Lintaroh/OMA68k/document/drawio/block_diagram.png

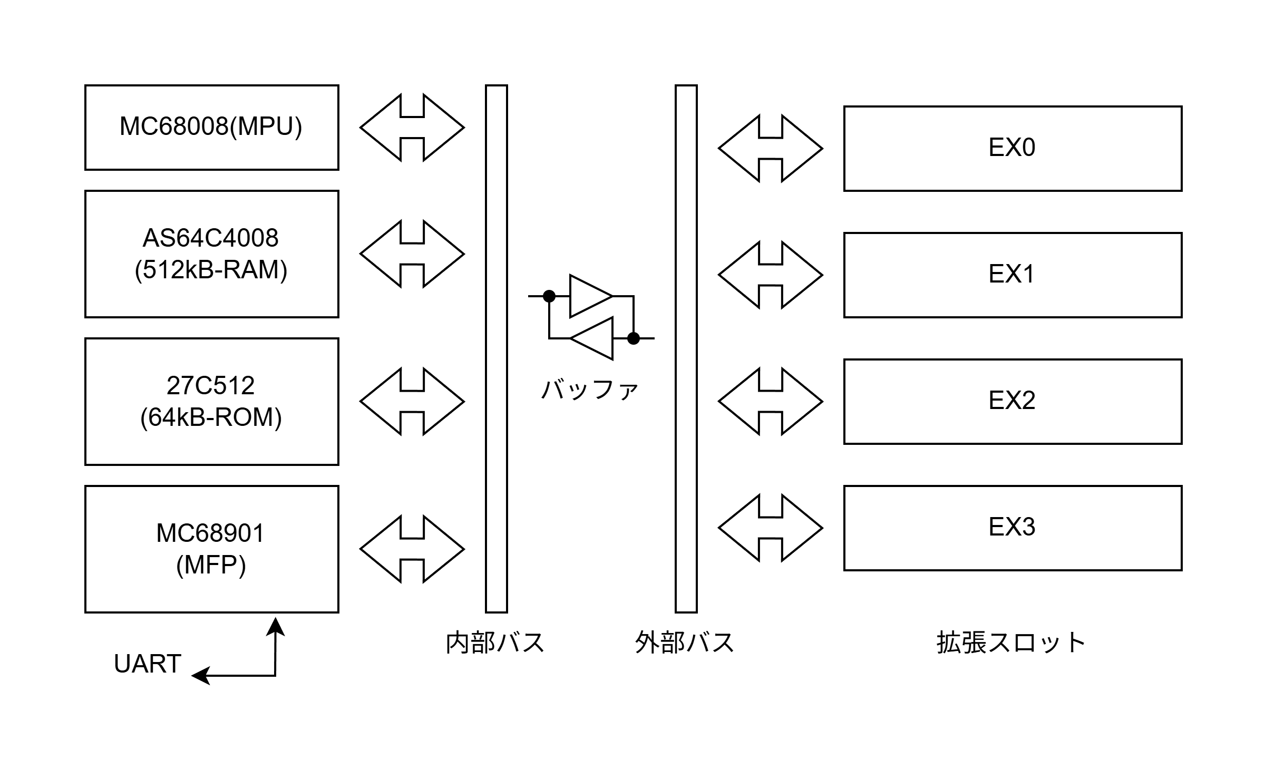
document/drawio/block_diagram.png
