Lintaroh/OMA68k/document/drawio/memorymap.png

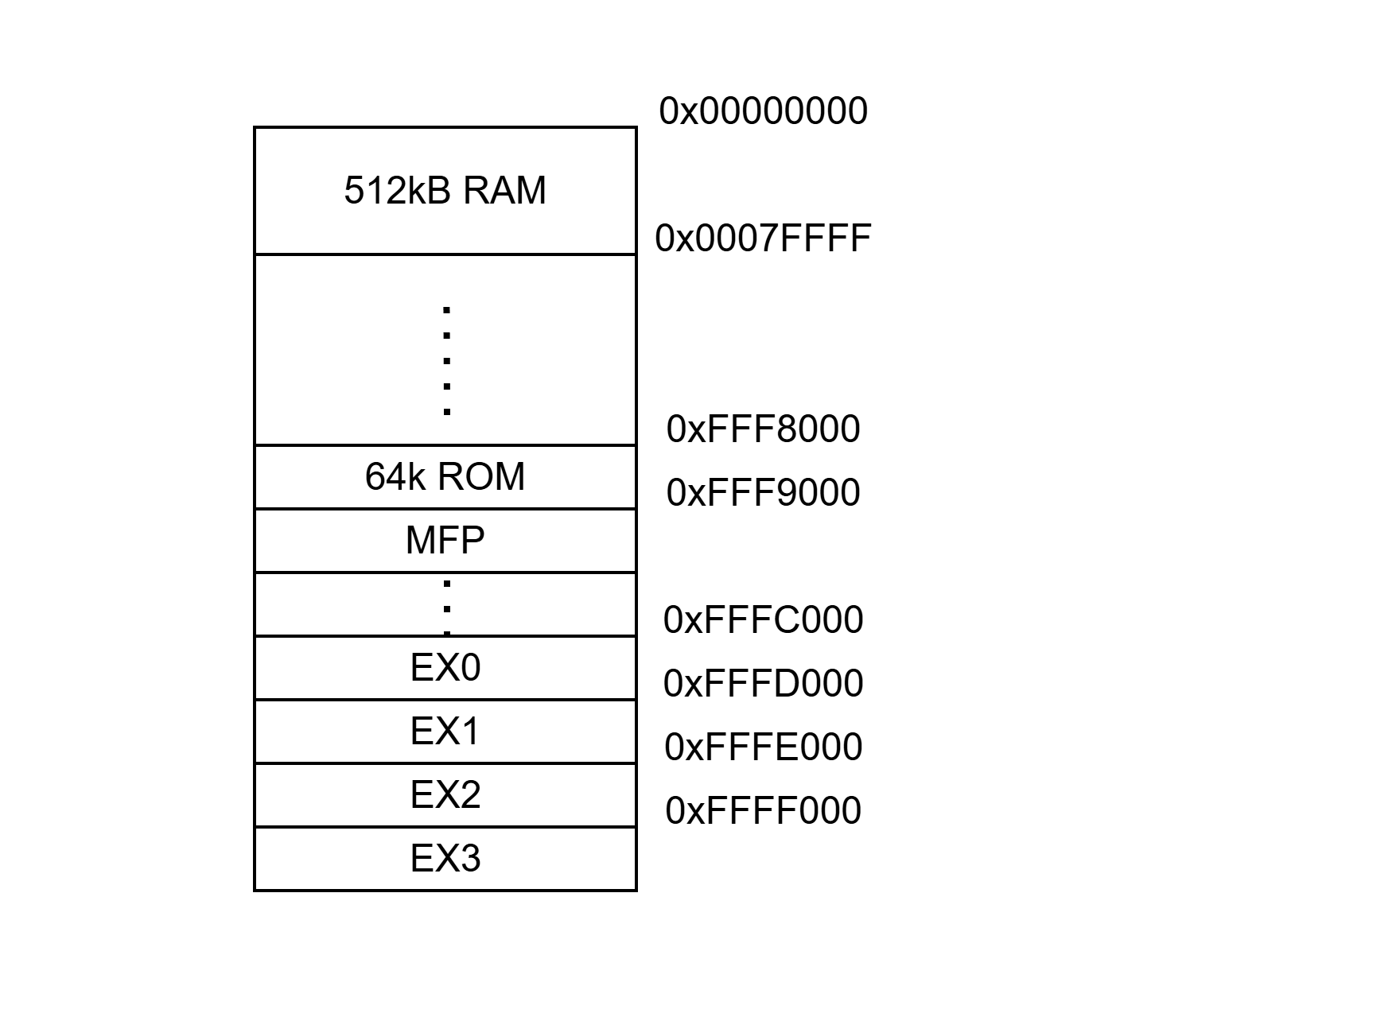
document/drawio/memorymap.png
