Lintaroh/OMA68k/(list of files, cad)

Other CAD files:
3D/48pin-socket.3dm
3D/64pin-socket.3dm
