Lintaroh/OMA68k/circuit/68k8-boad-fix/68k8-boad.pdf

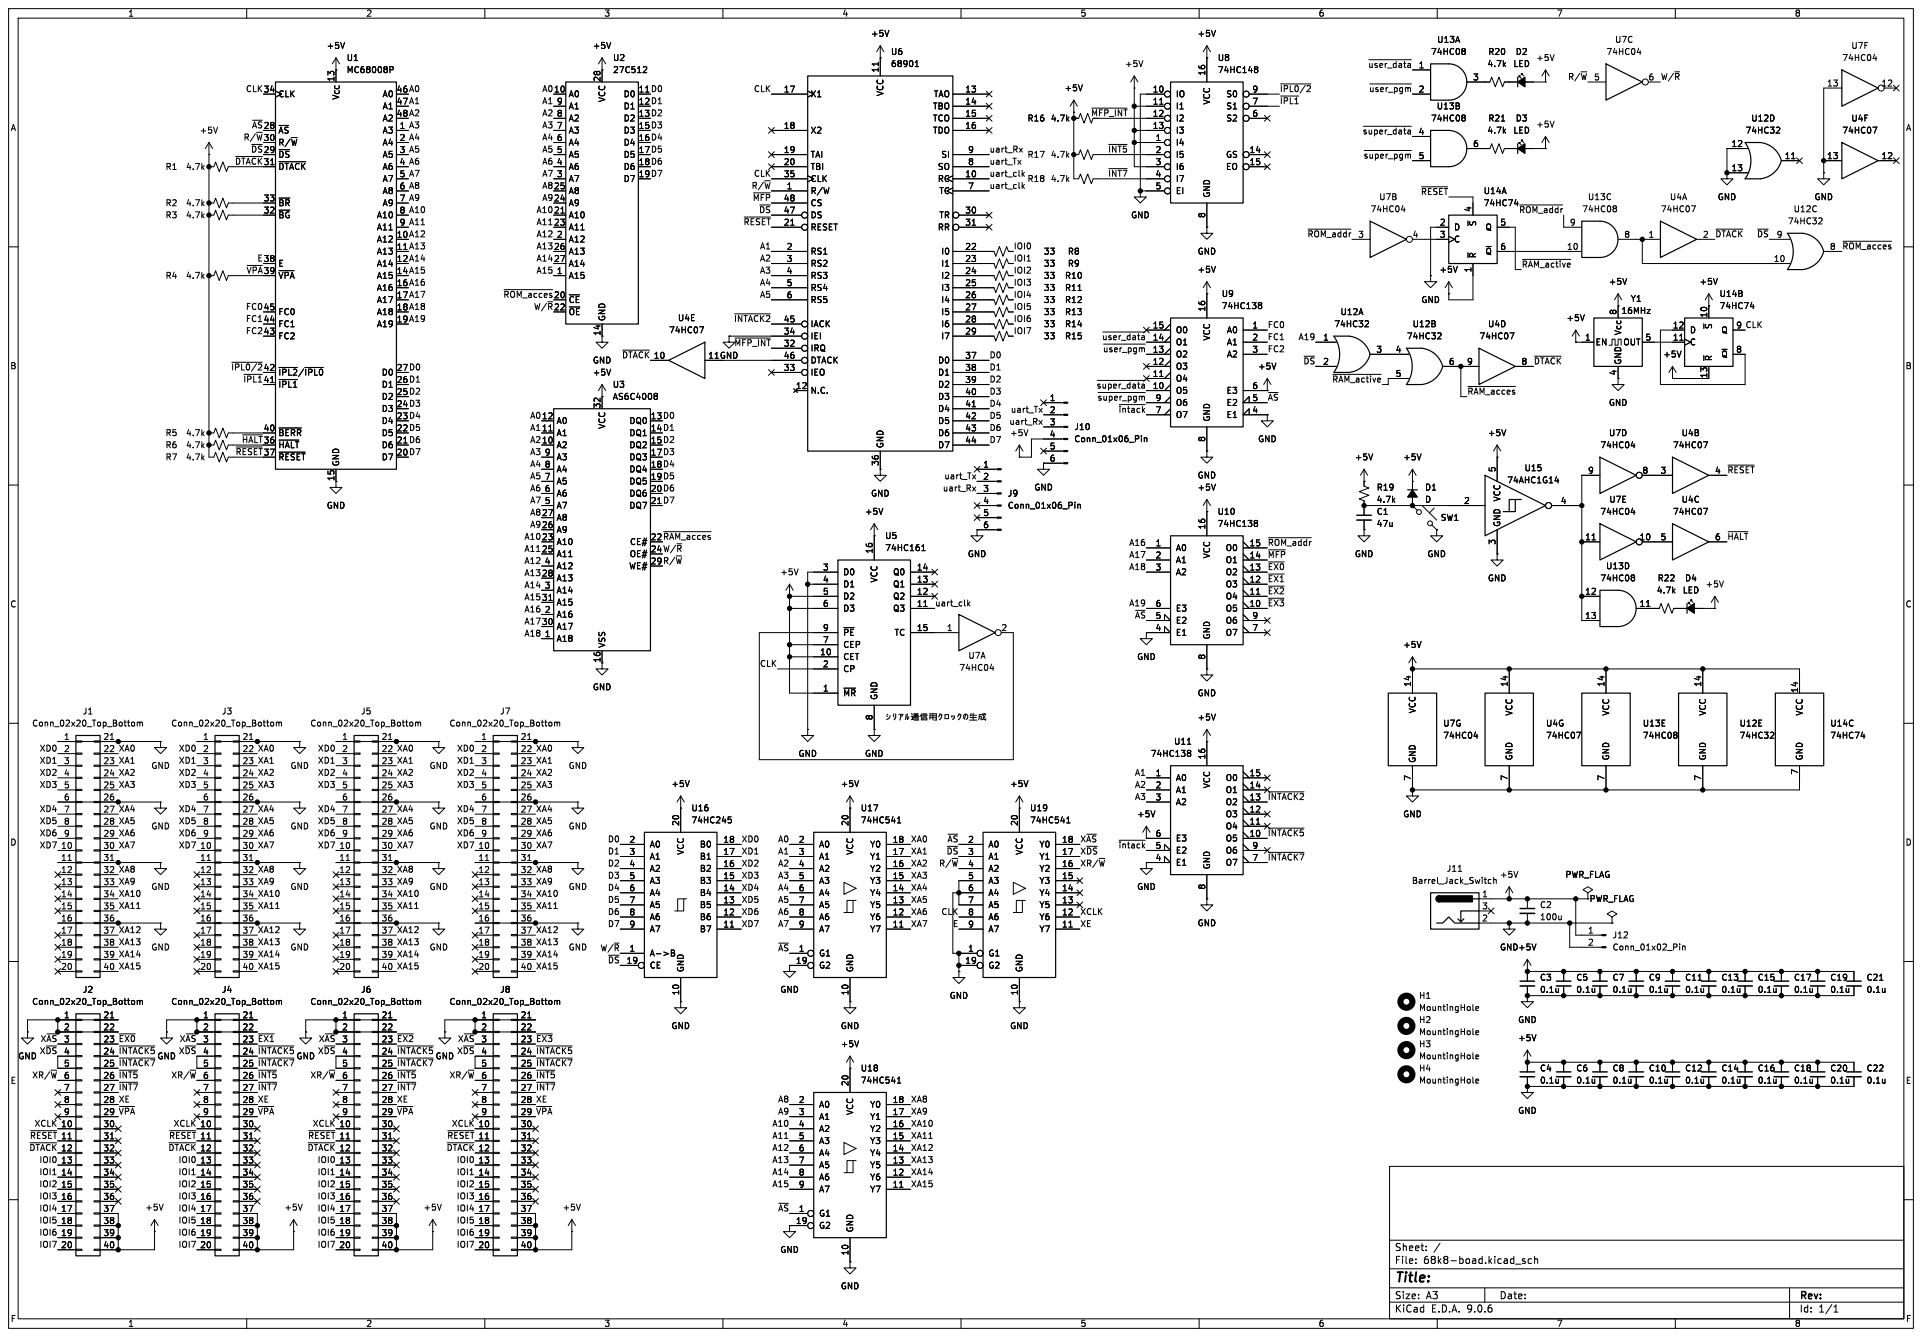
[picture p3: page 1]

CLK 34 ~{AS} 28 R/~{W} 30 ~{DS} 29 ~{DTACK} 31 ~{BR} 33 ~{BG} 32 E

U1 MC68008P CLK 34 ~{AS} 28 R/~{W} 30 ~{DS} 29 ~{DTACK} 31 ~{BR} 33 ~{BG} 32 E

H1 MountingHole H4 MountingHole H2 MountingHole H3 MountingHole

Id: 1/1 Title: File: 68k8-boad.kicad_sch Sheet: /
