Lintaroh/OMA68k/circuit/68k8-boad-fix/plots/68k8-boad__Assembly.pdf

# Reset RxD

# 74HC161 U7

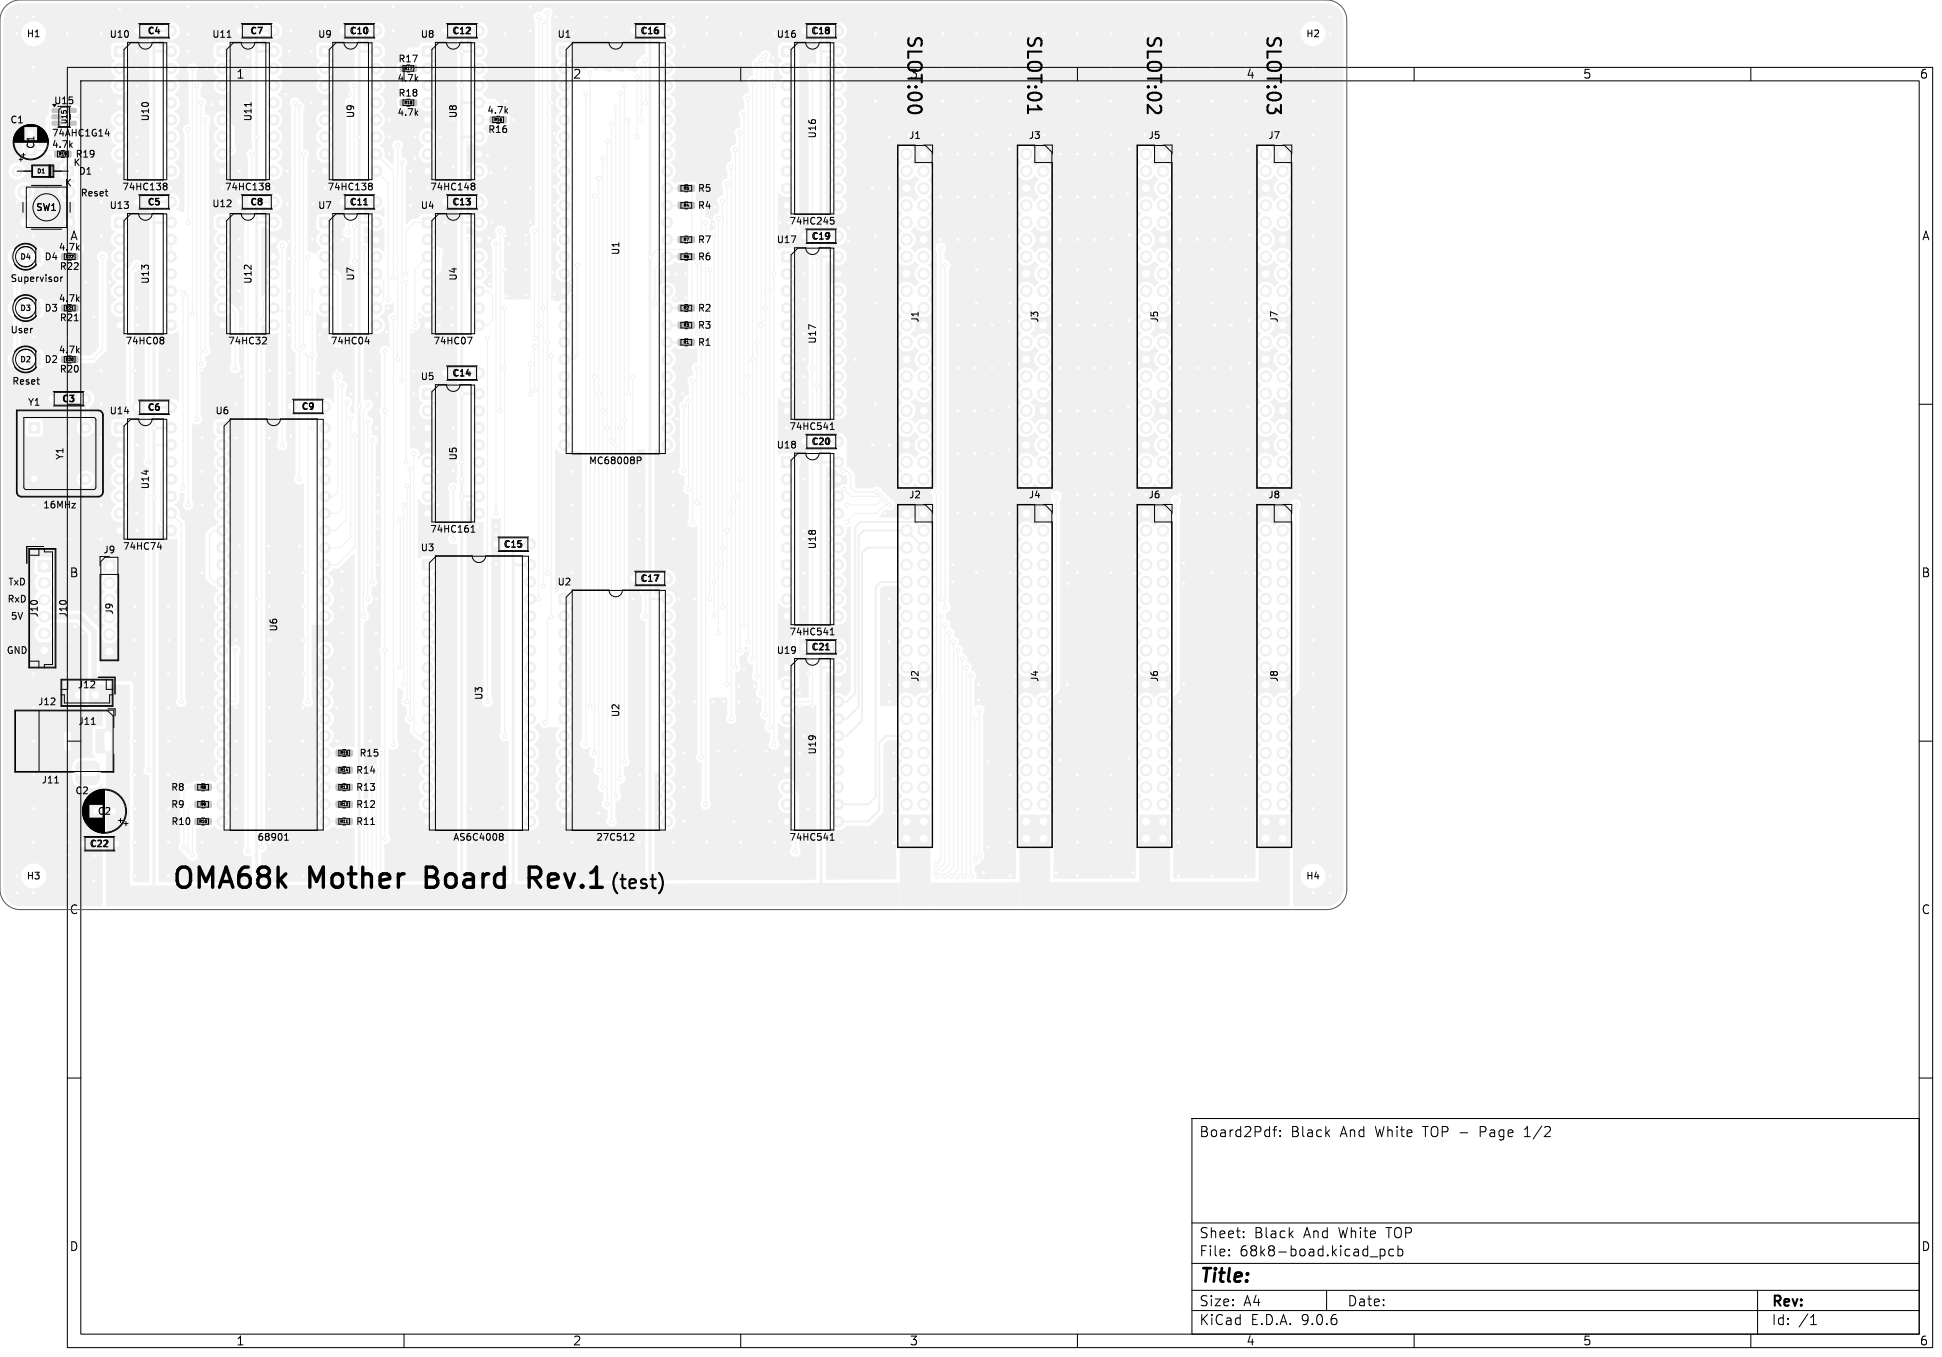
[picture p4: page 1]

Id: /1 Title: File: 68k8-boad.kicad_pcb Sheet: Black And White TOP

1 | 2 | 3 | 4 | 5 | 6

A

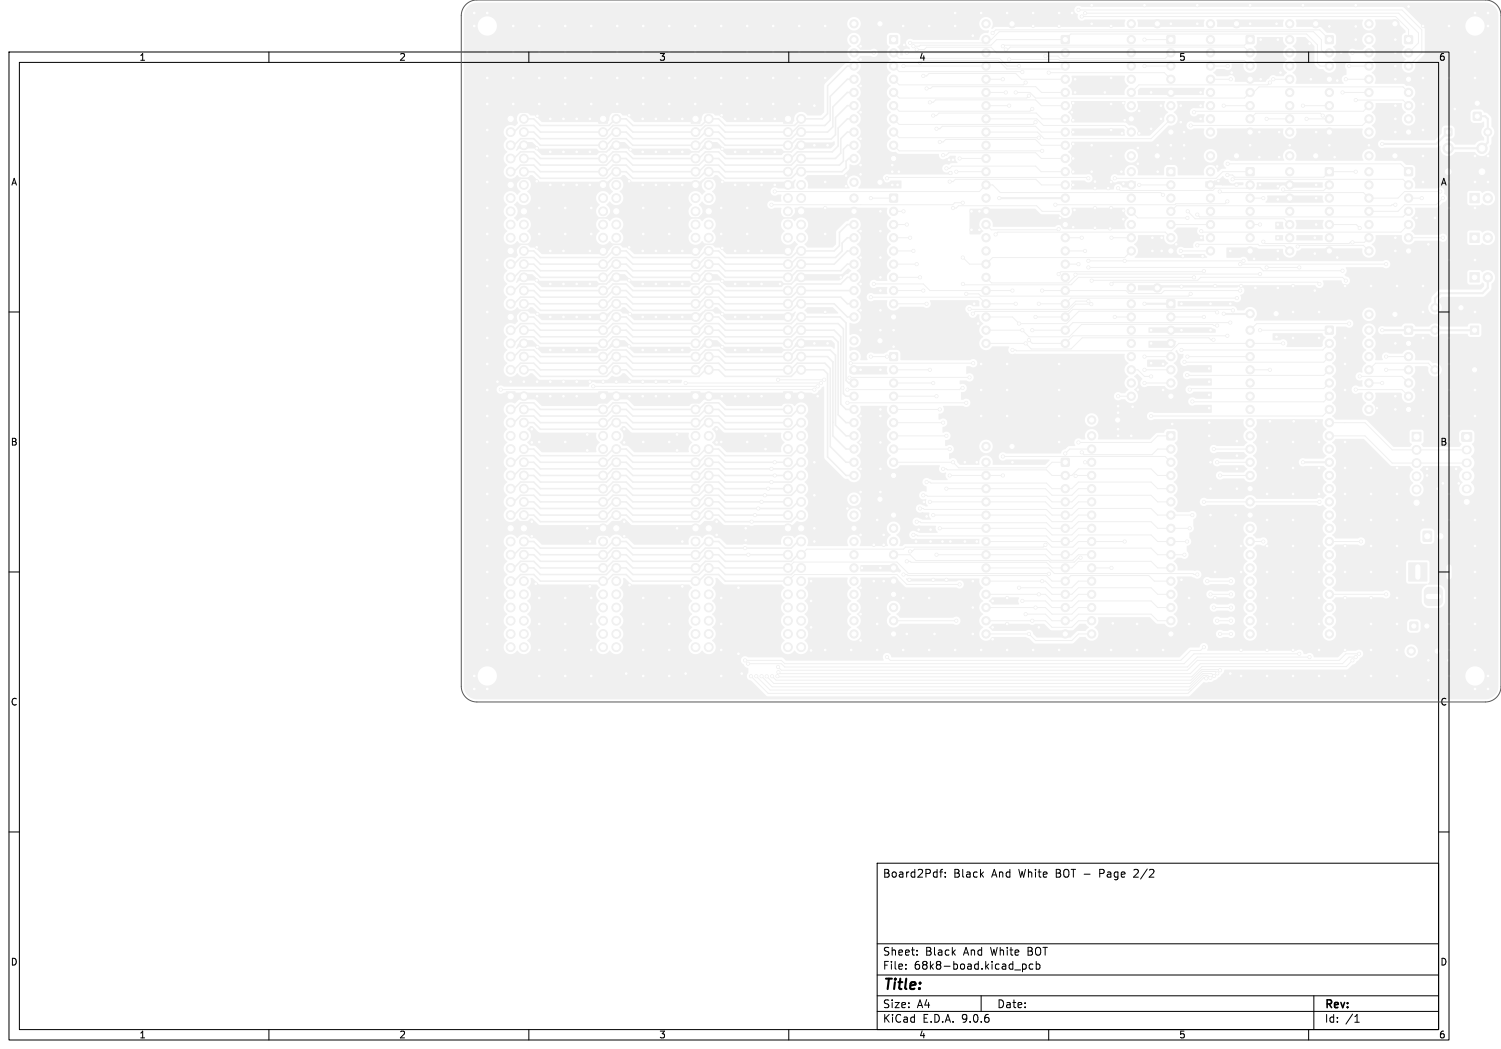
[picture p5: page 2]
D Date: KiCad; E.D.A. 9.0.6 Size: A4; Rev:; Id: /1 Title: File: 68k8-boad.kicad_pcb Sheet: Black And White BOT Board2Pdf:; Black And White BOT - Page 2/2
