Lintaroh/OMA68k/circuit/SD-board-pico/SD-board-pico.pdf

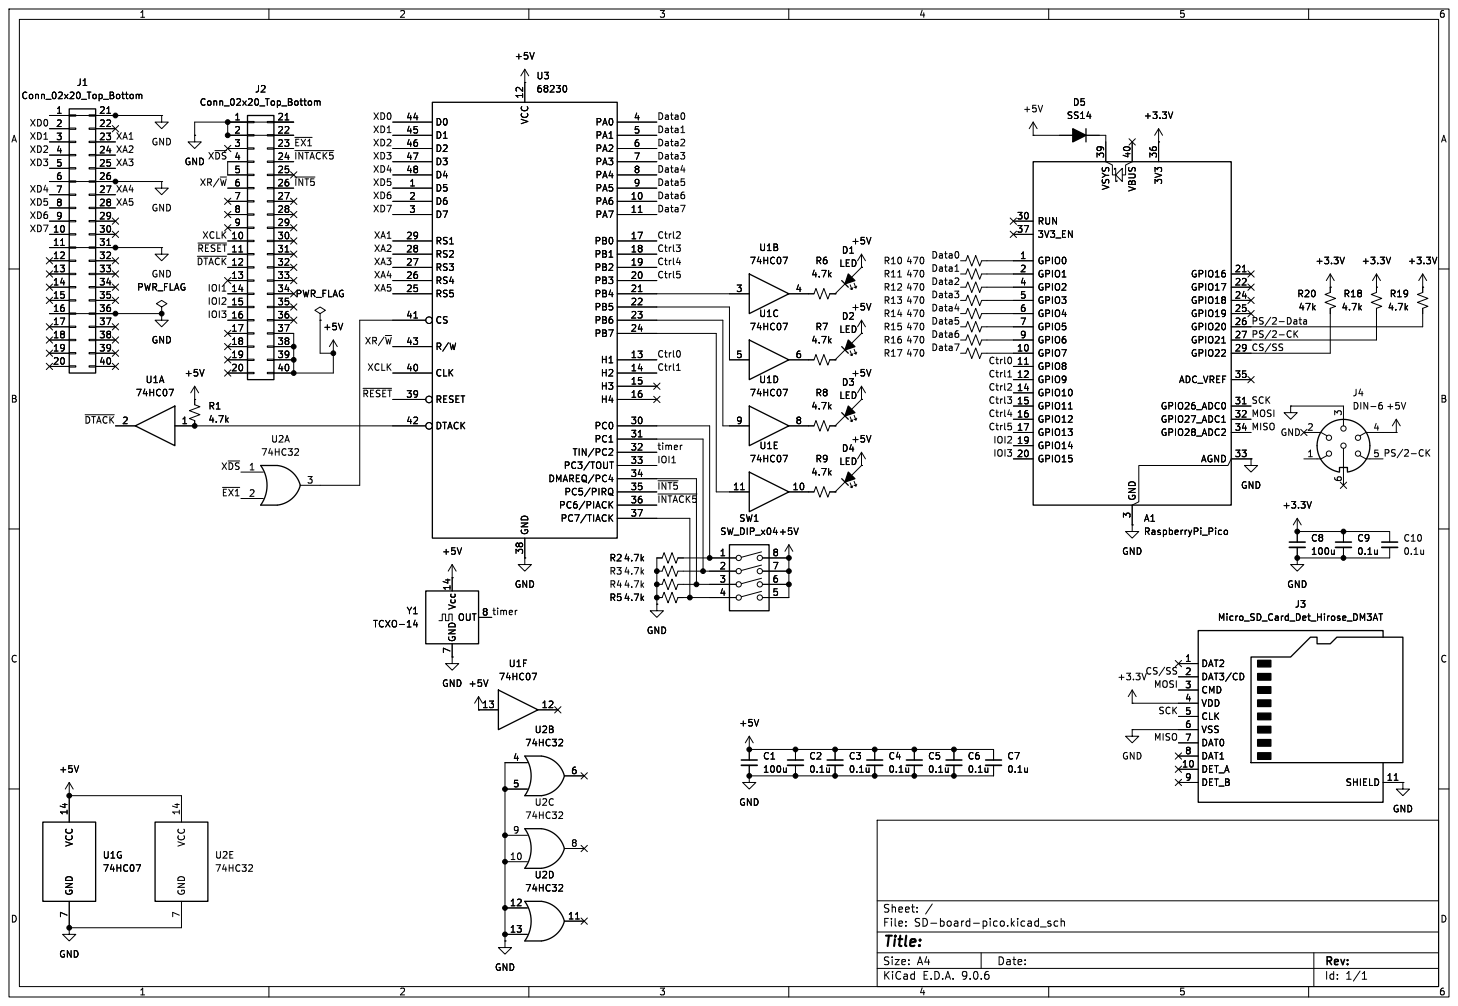
[picture p6: page 1]

Id: 1/1 Title: File: SD-board-pico.kicad_sch Sheet: / VCC 14 GND
