Lintaroh/OMA68k/circuit/SD-board/SD-board.pdf

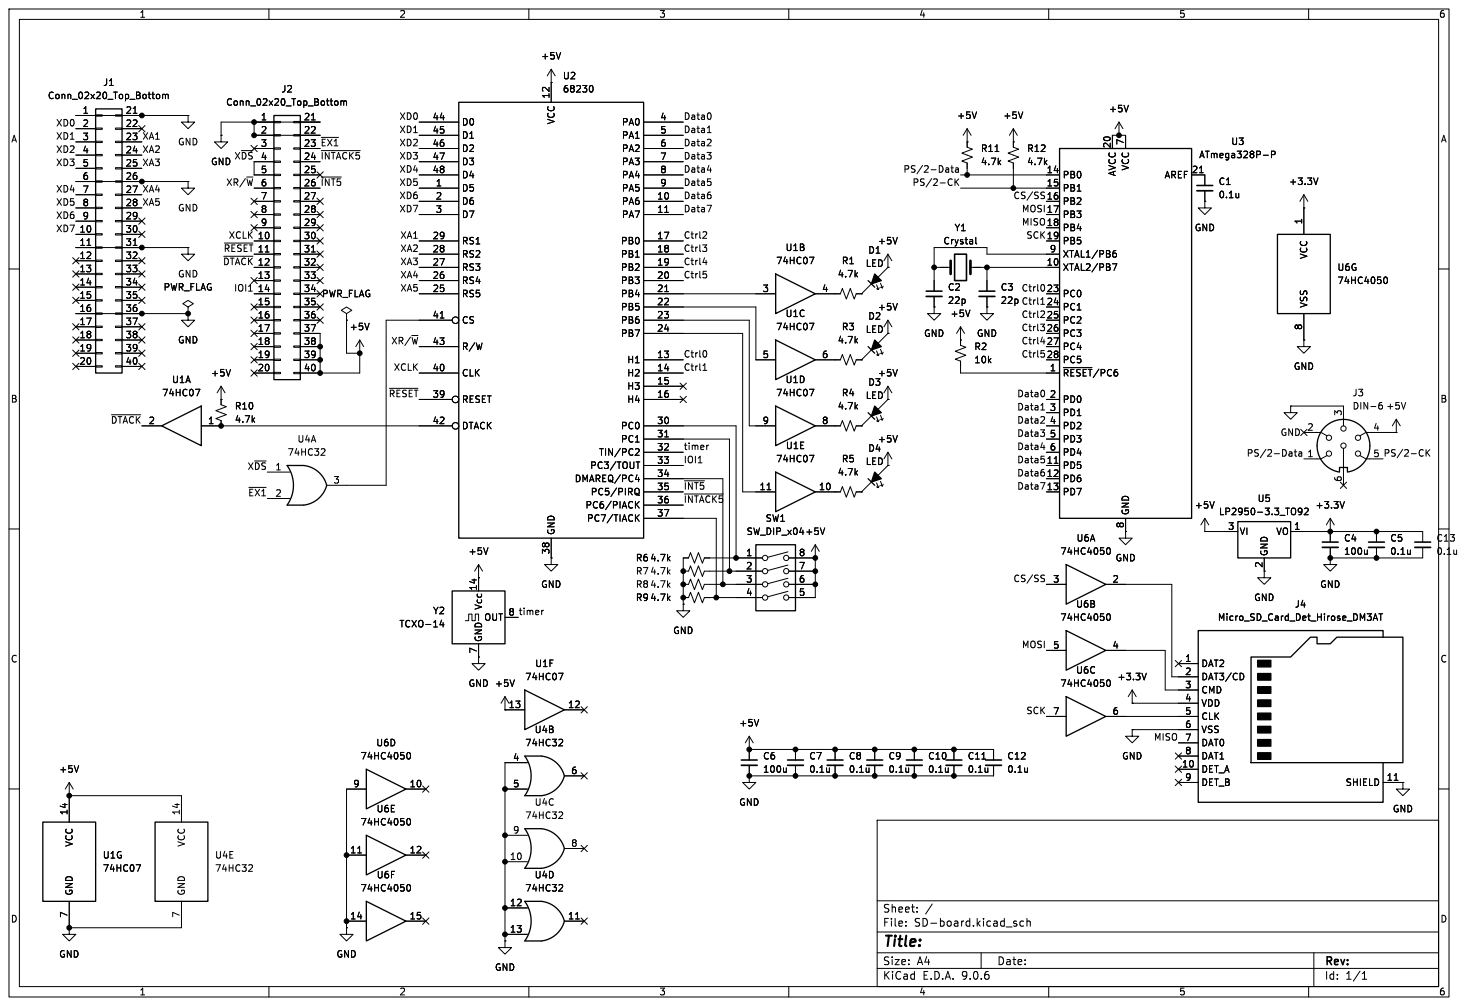
[picture p7: page 1]

Id: 1/1 Title: File: SD-board.kicad_sch Sheet: /
