Lintaroh/OMA68k/circuit/V9938-board/V9938-board.pdf

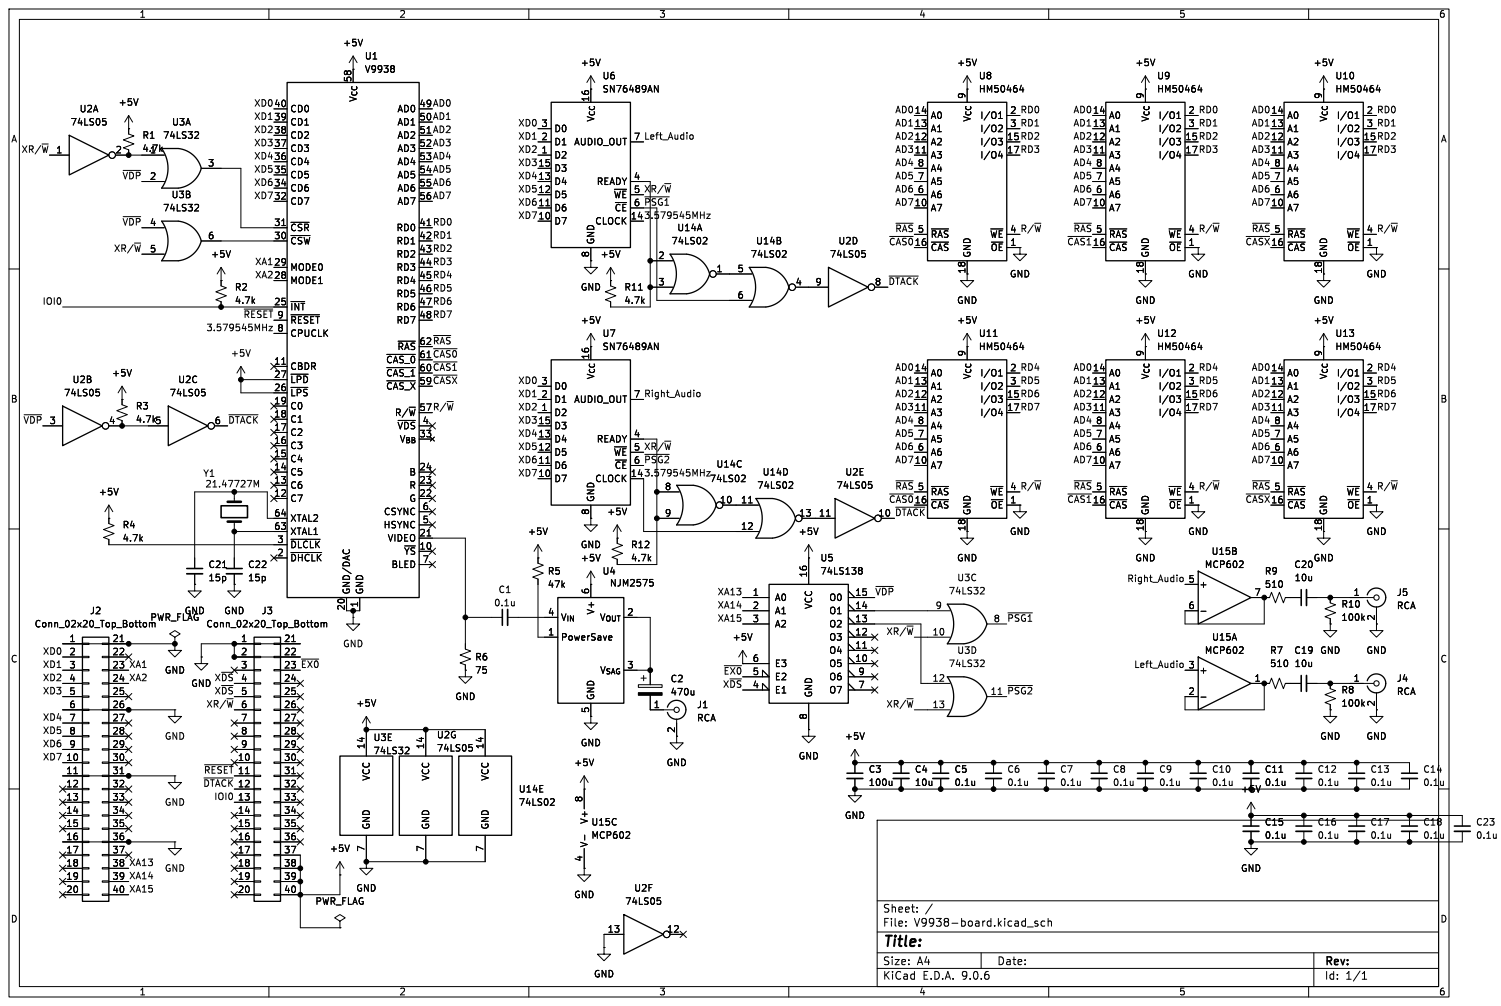
[picture p8: page 1]

22 CSYNC 6 HSYNC 5 VIDEO 21 ~{YS} 10 BLED 7 GND/DAC 20 +5V

8 AUDIO_OUT 7 READY 4 ~{WE}5 ~{CE}6 CLOCK 14 U6SN76489AN

8 AUDIO_OUT 7 READY 4 ~{WE}5 ~{CE}6 CLOCK 14 +5V R11

8 AUDIO_OUT 7 READY 4 ~{WE}5 ~{CE}6 CLOCK 14 U7SN76489AN

5 V_{OUT} 2 V_{SAG} 3 GND GND U2F
