Lintaroh/OMA68k/circuit/V9938-board/V9938-board.kicad_pcb

## KiCad design circuit/V9938-board/V9938-board.kicad_pcb (2026-05-15)

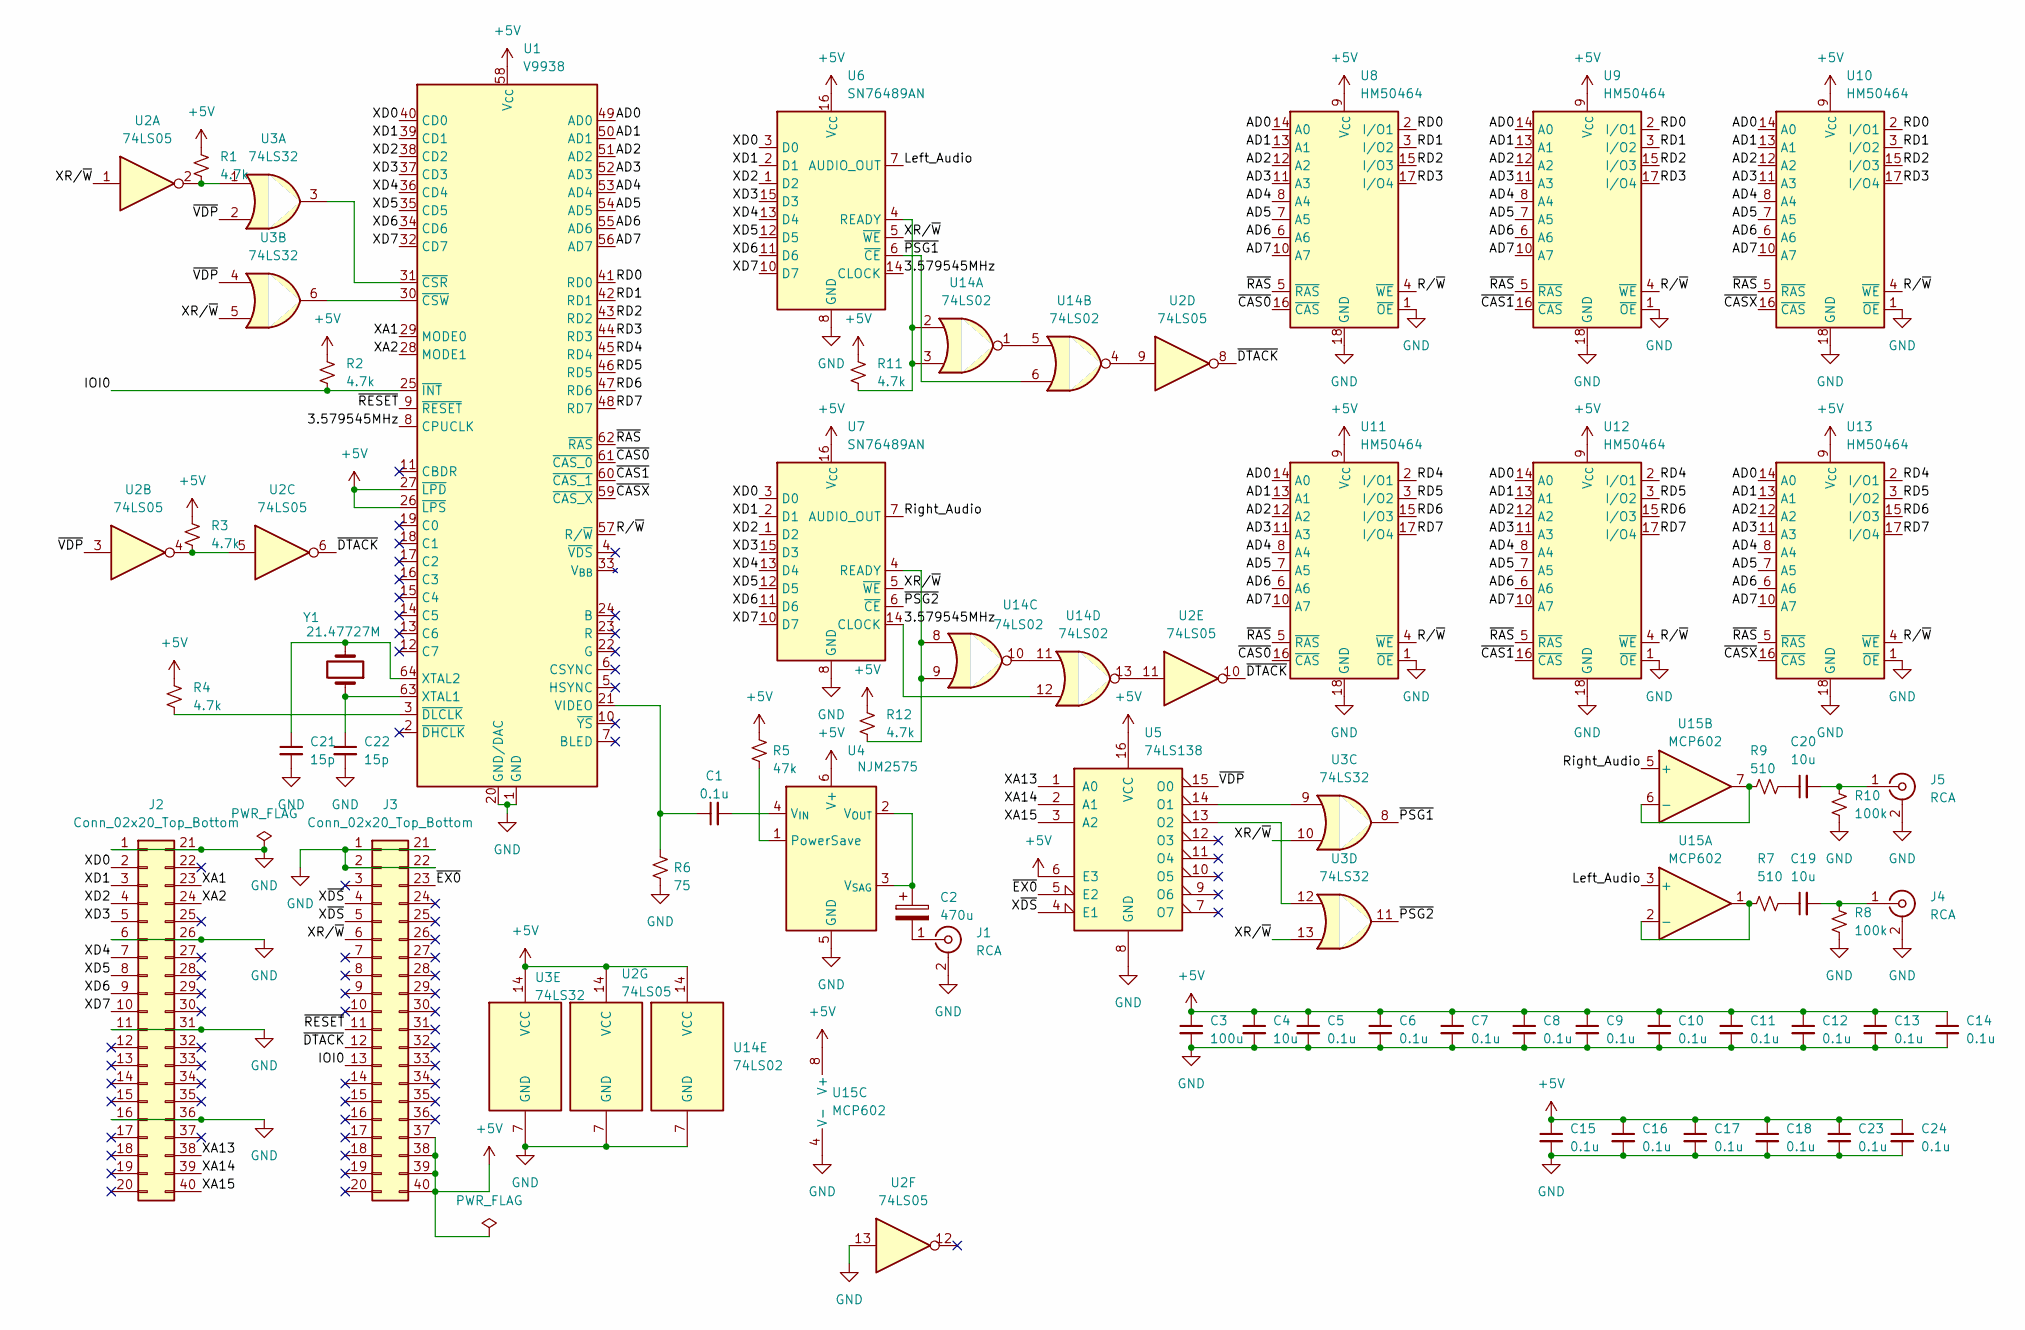
[picture p11: schematic V9938-board.kicad_sch]

Parts:
C1, C5, C6, C7, C8, C9, C10, C11, C12, C13, C14, C15, C16, C17, C18, C23, C24: 0.1u; C_Disc_D4.3mm_W1.9mm_P5.00mm
C2: 470u; CP_Radial_D8.0mm_P3.50mm
C3: 100u; CP_Radial_D6.3mm_P2.50mm
C4: 10u; CP_Radial_D5.0mm_P2.50mm
C19, C20: 10u; C_Disc_D4.7mm_W2.5mm_P5.00mm
C21, C22: 15p; C_0603_1608Metric
J1, J4, J5: RCA; RDJ
J2, J3: Conn_02x20_Top_Bottom; PinHeader_2x20_P2.54mm_Vertical
R1, R2, R3, R4, R11, R12: 4.7k; R_0603_1608Metric
R5: 47k; R_Axial_DIN0207_L6.3mm_D2.5mm_P10.16mm_Horizontal
R6: 75; R_Axial_DIN0207_L6.3mm_D2.5mm_P10.16mm_Horizontal
R7, R9: 510; R_Axial_DIN0207_L6.3mm_D2.5mm_P10.16mm_Horizontal
R8, R10: 100k; R_Axial_DIN0207_L6.3mm_D2.5mm_P10.16mm_Horizontal
U1: V9938; SDIP64
U2: 74LS05; DIP-14_W7.62mm
U3: 74LS32; DIP-14_W7.62mm
U4: NJM2575; SOT-23-6
U5: 74LS138; DIP-16_W7.62mm
U6, U7: SN76489AN; DIP-16_W7.62mm
U8, U9, U10, U11, U12, U13: HM50464; DIP-18_W7.62mm
U14: 74LS02; DIP-14_W7.62mm
U15: MCP602; DIP-8_W7.62mm
Y1: 21.47727M; Crystal_HC49-4H_Vertical

Connections:
+5V: C3.1, C4.1, C5.1, C6.1, C7.1, C8.1, C9.1, C10.1, C11.1, C12.1, C13.1, C14.1, C15.1, C16.1, C17.1, C18.1, C23.1, C24.1, J3.37, J3.38, J3.39, J3.40, R1.1, R2.1, R3.1, R4.1, R5.1, R11.1, R12.1, U1.26 (~LPS), U1.27 (~LPD), U1.58 (V_{CC}), U2.14 (VCC), U3.14 (VCC), U4.6 (V+), U5.6 (E3), U5.16 (VCC), U6.16 (V_{CC}), U7.16 (V_{CC}), U8.9 (V_{CC}), U9.9 (V_{CC}), U10.9 (V_{CC}), U11.9 (V_{CC}), U12.9 (V_{CC}), U13.9 (V_{CC}), U14.14 (VCC), U15.8 (V+)
/3.579545MHz: U1.8 (CPUCLK), U6.14 (CLOCK), U7.14 (CLOCK), U14.12
/AD0: U1.49 (AD0), U8.14 (A0), U9.14 (A0), U10.14 (A0), U11.14 (A0), U12.14 (A0), U13.14 (A0)
/AD1: U1.50 (AD1), U8.13 (A1), U9.13 (A1), U10.13 (A1), U11.13 (A1), U12.13 (A1), U13.13 (A1)
/AD2: U1.51 (AD2), U8.12 (A2), U9.12 (A2), U10.12 (A2), U11.12 (A2), U12.12 (A2), U13.12 (A2)
/AD3: U1.52 (AD3), U8.11 (A3), U9.11 (A3), U10.11 (A3), U11.11 (A3), U12.11 (A3), U13.11 (A3)
/AD4: U1.53 (AD4), U8.8 (A4), U9.8 (A4), U10.8 (A4), U11.8 (A4), U12.8 (A4), U13.8 (A4)
/AD5: U1.54 (AD5), U8.7 (A5), U9.7 (A5), U10.7 (A5), U11.7 (A5), U12.7 (A5), U13.7 (A5)
/AD6: U1.55 (AD6), U8.6 (A6), U9.6 (A6), U10.6 (A6), U11.6 (A6), U12.6 (A6), U13.6 (A6)
/AD7: U1.56 (AD7), U8.10 (A7), U9.10 (A7), U10.10 (A7), U11.10 (A7), U12.10 (A7), U13.10 (A7)
/IOI0: J3.13, R2.2, U1.25 (~INT)
/Left_Audio: U6.7 (AUDIO_OUT), U15.3 (+)
/RD0: U1.41 (RD0), U8.2 (I/O1), U9.2 (I/O1), U10.2 (I/O1)
/RD1: U1.42 (RD1), U8.3 (I/O2), U9.3 (I/O2), U10.3 (I/O2)
/RD2: U1.43 (RD2), U8.15 (I/O3), U9.15 (I/O3), U10.15 (I/O3)
/RD3: U1.44 (RD3), U8.17 (I/O4), U9.17 (I/O4), U10.17 (I/O4)
/RD4: U1.45 (RD4), U11.2 (I/O1), U12.2 (I/O1), U13.2 (I/O1)
/RD5: U1.46 (RD5), U11.3 (I/O2), U12.3 (I/O2), U13.3 (I/O2)
/RD6: U1.47 (RD6), U11.15 (I/O3), U12.15 (I/O3), U13.15 (I/O3)
/RD7: U1.48 (RD7), U11.17 (I/O4), U12.17 (I/O4), U13.17 (I/O4)
/Right_Audio: U7.7 (AUDIO_OUT), U15.5 (+)
/R/~W: U1.57 (R/~W), U8.4 (~WE), U9.4 (~WE), U10.4 (~WE), U11.4 (~WE), U12.4 (~WE), U13.4 (~WE)
/XA1: J2.23, U1.29 (MODE0)
/XA2: J2.24, U1.28 (MODE1)
/XA13: J2.38, U5.1 (A0)
/XA14: J2.39, U5.2 (A1)
/XA15: J2.40, U5.3 (A2)
/XD0: J2.2, U1.40 (CD0), U6.3 (D0), U7.3 (D0)
/XD1: J2.3, U1.39 (CD1), U6.2 (D1), U7.2 (D1)
/XD2: J2.4, U1.38 (CD2), U6.1 (D2), U7.1 (D2)
/XD3: J2.5, U1.37 (CD3), U6.15 (D3), U7.15 (D3)
/XD4: J2.7, U1.36 (CD4), U6.13 (D4), U7.13 (D4)
/XD5: J2.8, U1.35 (CD5), U6.12 (D5), U7.12 (D5)
/XD6: J2.9, U1.34 (CD6), U6.11 (D6), U7.11 (D6)
/XD7: J2.10, U1.32 (CD7), U6.10 (D7), U7.10 (D7)
/XR/~W: J3.6, U2.1, U3.5, U3.10, U3.13, U6.5 (~WE), U7.5 (~WE)
/X~DS: J3.4, J3.5, U5.4 (E1)
/~CAS0: U1.61 (~CAS_0), U8.16 (~CAS), U11.16 (~CAS)
/~CAS1: U1.60 (~CAS_1), U9.16 (~CAS), U12.16 (~CAS)
/~CASX: U1.59 (~CAS_X), U10.16 (~CAS), U13.16 (~CAS)
/~DTACK: J3.12, U2.6, U2.8, U2.10
/~EX0: J3.23, U5.5 (E2)
/~PSG1: U3.8, U6.6 (~CE), U14.6
/~PSG2: U3.11, U7.6 (~CE)
/~RAS: U1.62 (~RAS), U8.5 (~RAS), U9.5 (~RAS), U10.5 (~RAS), U11.5 (~RAS), U12.5 (~RAS), U13.5 (~RAS)
/~RESET: J3.11, U1.9 (~RESET)
/~VDP: U2.3, U3.2, U3.4, U5.15 (O0)
GND: C3.2, C4.2, C5.2, C6.2, C7.2, C8.2, C9.2, C10.2, C11.2, C12.2, C13.2, C14.2, C15.2, C16.2, C17.2, C18.2, C21.2, C22.2, C23.2, C24.2, J1.2 (Ext), J2.1, J2.6, J2.11, J2.16, J2.21, J2.26, J2.31, J2.36, J3.1, J3.2, J3.21, J3.22, J4.2 (Ext), J5.2 (Ext), R6.2, R8.2, R10.2, U1.1 (GND), U1.20 (GND/DAC), U2.7 (GND), U2.13, U3.7 (GND), U4.5 (GND), U5.8 (GND), U6.8 (GND), U7.8 (GND), U8.1 (~OE), U8.18 (GND), U9.1 (~OE), U9.18 (GND), U10.1 (~OE), U10.18 (GND), U11.1 (~OE), U11.18 (GND), U12.1 (~OE), U12.18 (GND), U13.1 (~OE), U13.18 (GND), U14.7 (GND), U15.4 (V-)
unnamed: C19.1, R7.2
unnamed: C20.1, R9.2
unnamed: C2.2, J1.1 (In)
unnamed: C19.2, J4.1 (In), R8.1
unnamed: C20.2, J5.1 (In), R10.1
unnamed: R1.2, U2.2, U3.1
unnamed: R3.2, U2.4, U2.5
unnamed: C1.1, R6.1, U1.21 (VIDEO)
unnamed: C22.1, U1.63 (XTAL1), Y1.1
unnamed: C21.1, U1.64 (XTAL2), Y1.2
unnamed: U1.31 (~CSR), U3.3
unnamed: U1.30 (~CSW), U3.6
unnamed: R4.2, U1.3 (~DLCLK)
unnamed: R5.2, U4.1 (PowerSave)
unnamed: C1.2, U4.4 (V_{IN})
unnamed: C2.1, U4.2 (V_{OUT}), U4.3 (V_{SAG})
unnamed: U3.9, U5.14 (O1)
unnamed: U3.12, U5.13 (O2)
unnamed: R11.2, U6.4 (READY), U14.2, U14.3
unnamed: R12.2, U7.4 (READY), U14.8, U14.9
unnamed: U14.1, U14.5
unnamed: U2.9, U14.4
unnamed: U14.10, U14.11
unnamed: U2.11, U14.13
unnamed: R7.1, U15.1, U15.2 (-)
unnamed: R9.1, U15.6 (-), U15.7

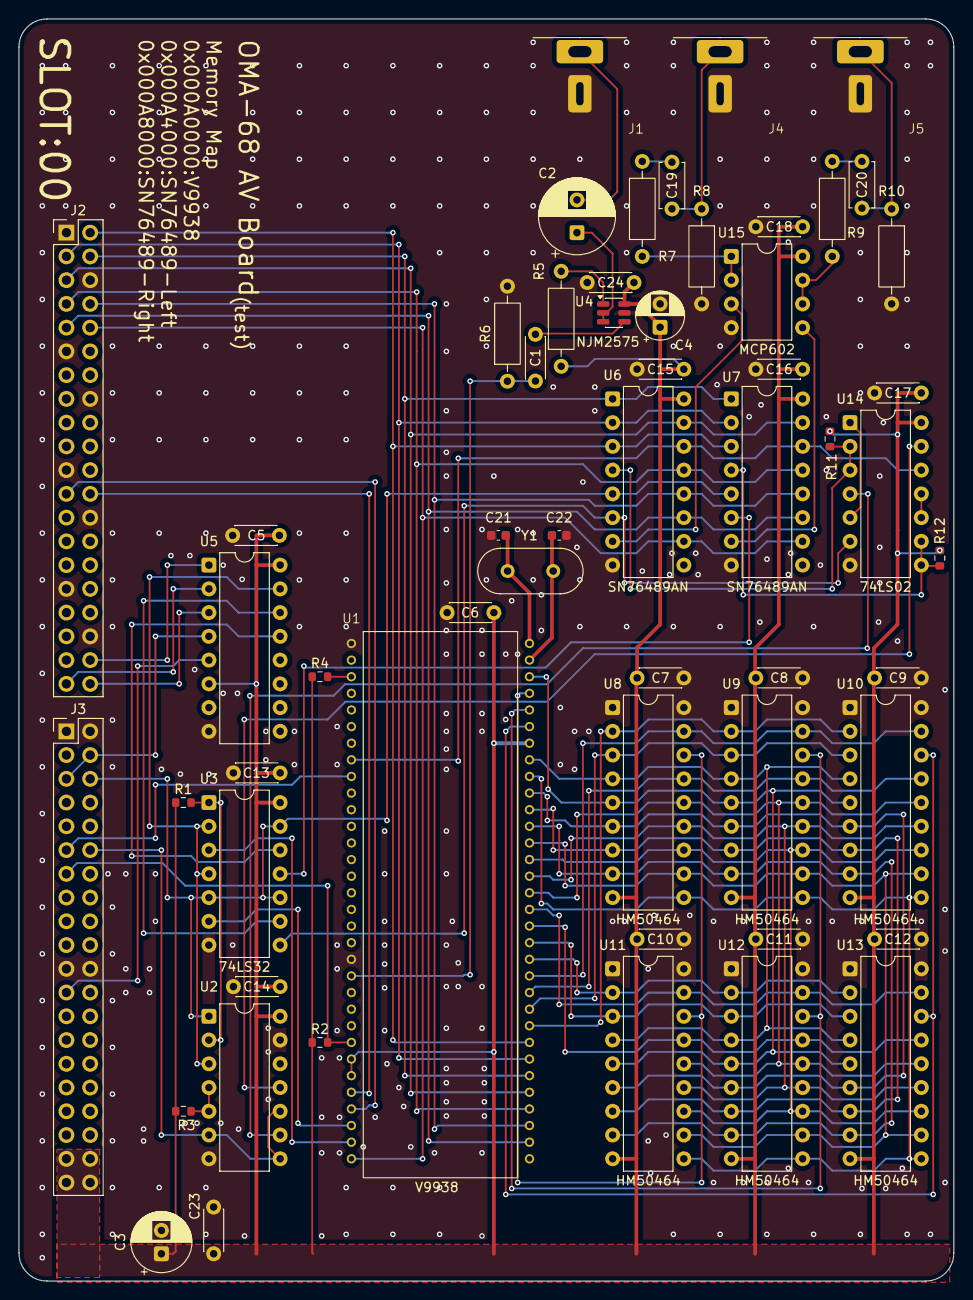
[picture p12: board V9938-board.kicad_pcb from above]

Board: 2 copper layers, 100.0 x 135.0 mm, 57 parts (0 on the bottom side), 74 nets.
