Lintaroh/OMA68k/circuit/68k8-boad-fix/68k8-boad.kicad_pcb

## KiCad design circuit/68k8-boad-fix/68k8-boad.kicad_pcb (2026-05-15)

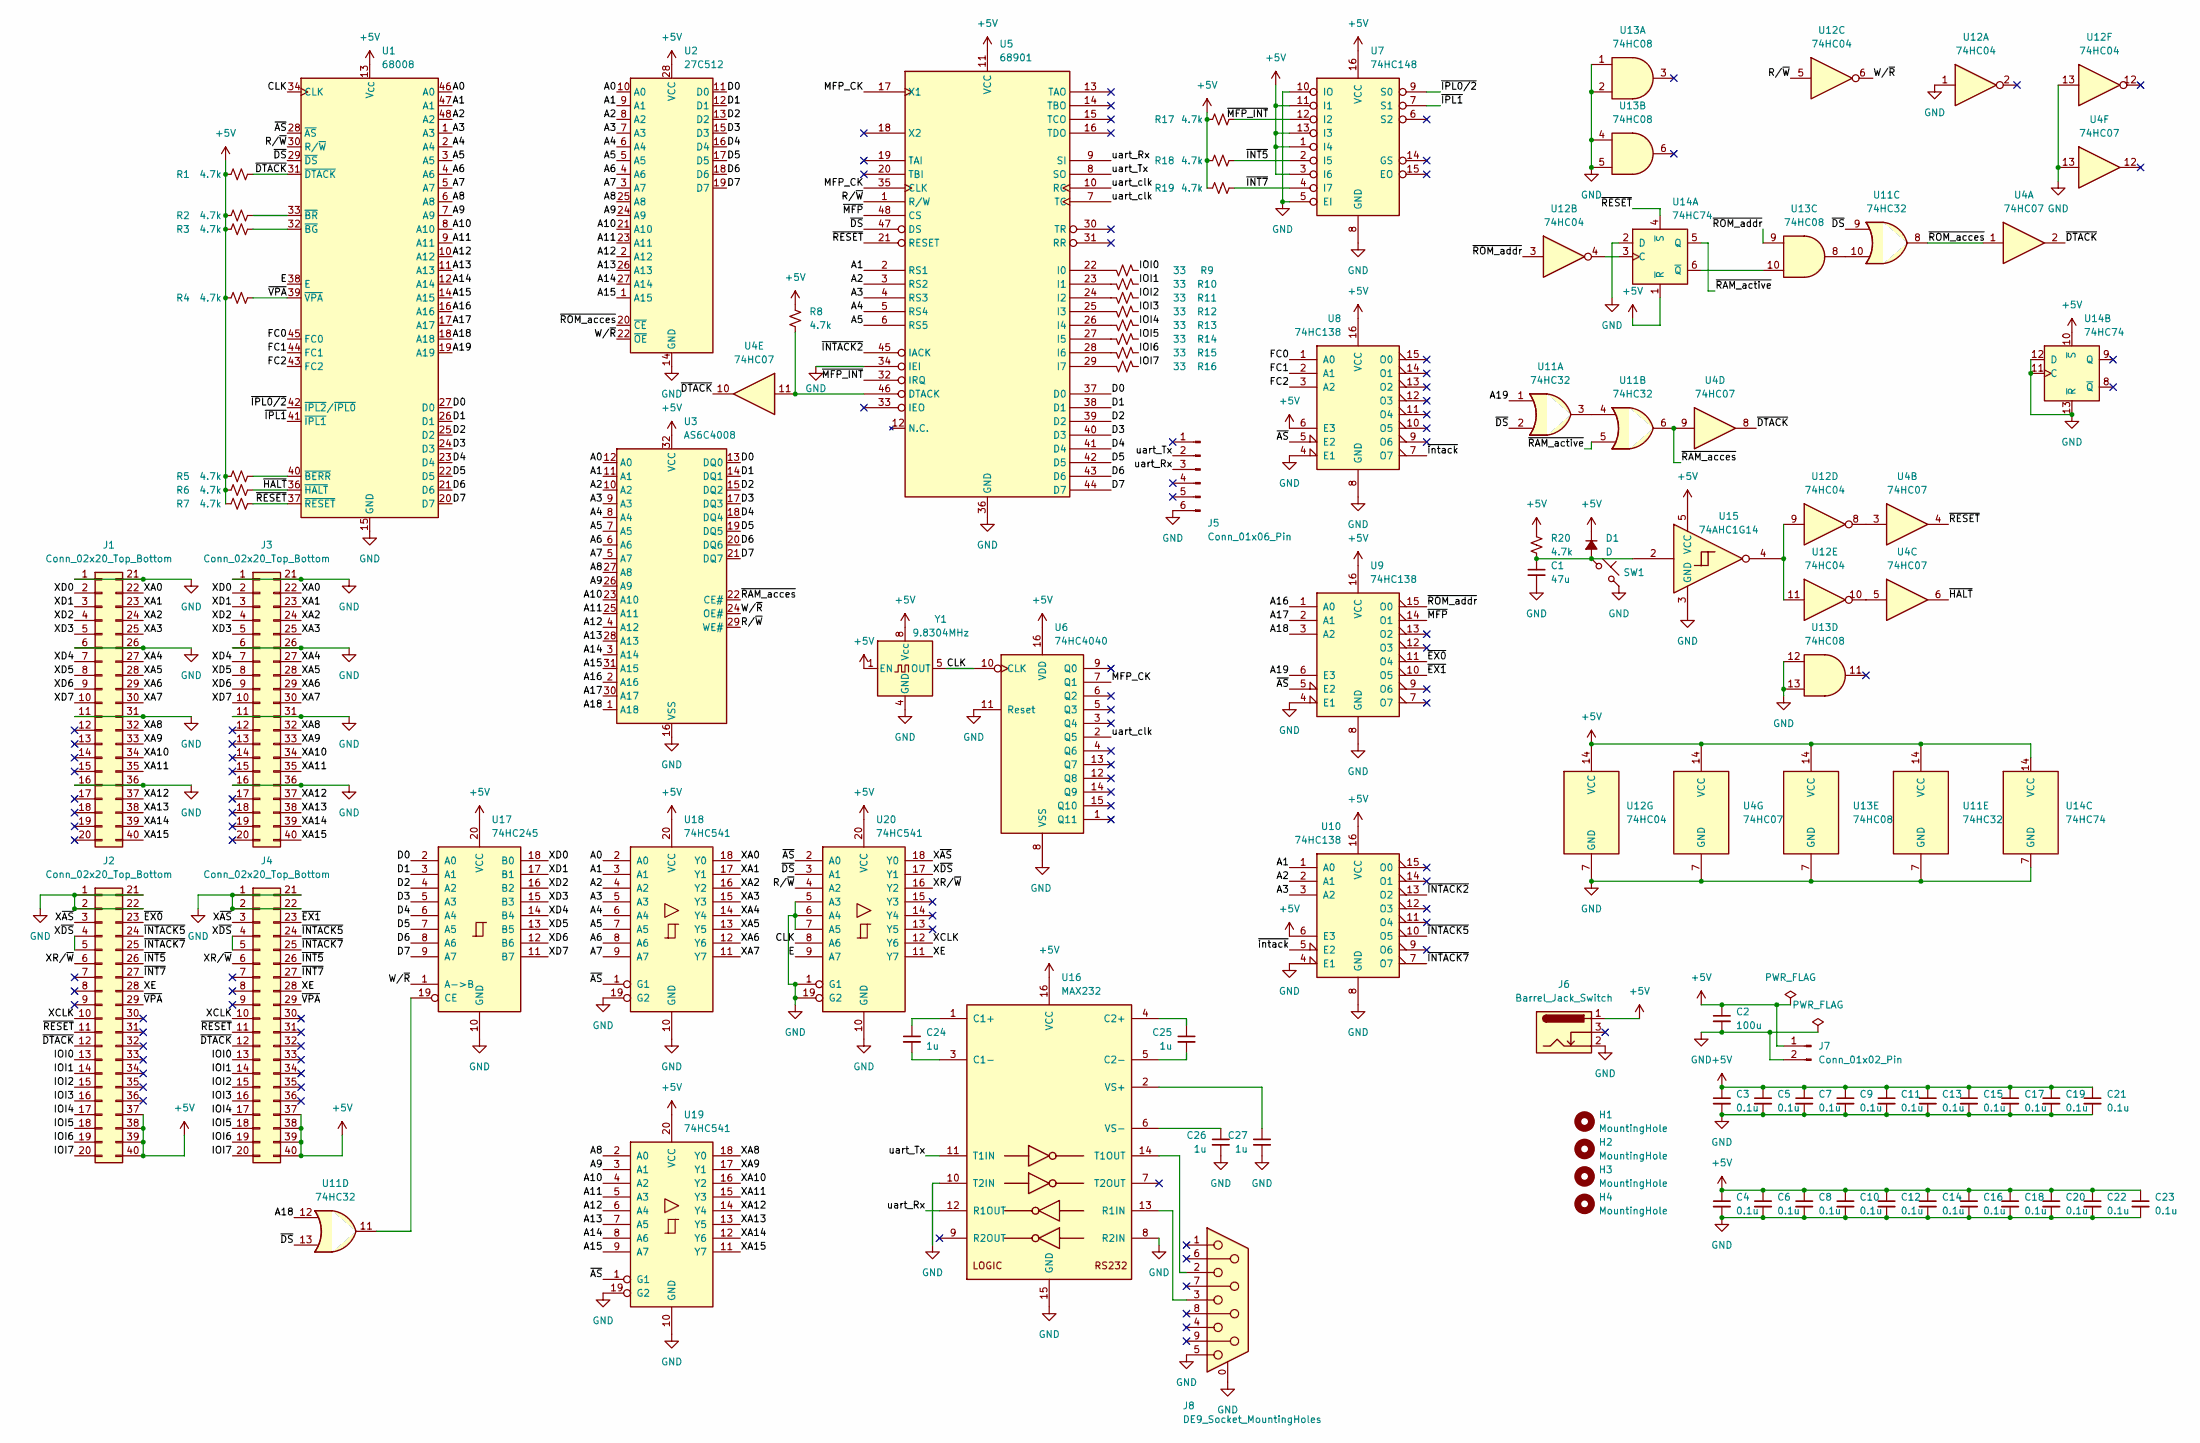
[picture p13: schematic 68k8-boad.kicad_sch]

Parts:
C1: 47u; CP_Radial_D5.0mm_P2.50mm
C2: 100u; CP_Radial_D6.3mm_P2.50mm
C3, C4, C5, C6, C7, C8, C9, C10, C11, C12, C13, C14, C15, C16, C17, C18, C19, C20, C21, C22, C23: 0.1u; C_Disc_D4.3mm_W1.9mm_P5.00mm
C24, C25, C26, C27: 1u; C_0805_2012Metric
D1: D; D_DO-34_SOD68_P7.62mm_Horizontal
H1, H2, H3, H4: MountingHole; MountingHole_3.2mm_M3
J1, J2, J3, J4: Conn_02x20_Top_Bottom; PinSocket_2x20_P2.54mm_Vertical
J5: Conn_01x06_Pin; PinHeader_1x06_P2.54mm_Vertical
J6: Barrel_Jack_Switch; BarrelJack_Horizontal
J7: Conn_01x02_Pin; JST_EH_B2B-EH-A_1x02_P2.50mm_Vertical
J8: DE9_Socket_MountingHoles; DSUB-9_Socket_Horizontal_P2.77x2.84mm_EdgePinOffset7.70mm_H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
R1, R2, R3, R4, R5, R6, R7, R8, R17, R18, R19, R20: 4.7k; R_0603_1608Metric
R9, R10, R11, R12, R13, R14, R15, R16: 33; R_0603_1608Metric
SW1: SW_PUSH_6mm_H5mm
U1: 68008; DIP-48_W15.24mm
U2: 27C512; DIP-28_W15.24mm
U3: AS6C4008; DIP-32_W15.24mm
U4: 74HC07; DIP-14_W7.62mm
U5: 68901; DIP-48_W15.24mm
U6: 74HC4040; DIP-16_W7.62mm
U7: 74HC148; DIP-16_W7.62mm
U8, U9, U10: 74HC138; DIP-16_W7.62mm
U11: 74HC32; DIP-14_W7.62mm
U12: 74HC04; DIP-14_W7.62mm
U13: 74HC08; DIP-14_W7.62mm
U14: 74HC74; DIP-14_W7.62mm
U15: 74AHC1G14; SOT-23-5
U16: MAX232; DIP-16_W7.62mm
U17: 74HC245; DIP-20_W7.62mm
U18, U19, U20: 74HC541; DIP-20_W7.62mm
Y1: 9.8304MHz; Oscillator_DIP-8

Connections:
+5V: C2.1, C3.1, C4.1, C5.1, C6.1, C7.1, C8.1, C9.1, C10.1, C11.1, C12.1, C13.1, C14.1, C15.1, C16.1, C17.1, C18.1, C19.1, C20.1, C21.1, C22.1, C23.1, D1.1 (K), J2.37, J2.38, J2.39, J2.40, J4.37, J4.38, J4.39, J4.40, J6.1, J7.1, R1.1, R2.1, R3.1, R4.1, R5.1, R6.1, R7.1, R8.1, R17.1, R18.1, R19.1, R20.1, U1.13 (V_{CC}), U2.28 (VCC), U3.32 (VCC), U4.14 (VCC), U5.11 (VCC), U6.16 (VDD), U7.1 (I4), U7.3 (I6), U7.11 (I1), U7.13 (I3), U7.16 (VCC), U8.6 (E3), U8.16 (VCC), U9.16 (VCC), U10.6 (E3), U10.16 (VCC), U11.14 (VCC), U12.14 (VCC), U13.14 (VCC), U14.1 (~R), U14.10 (~S), U14.14 (VCC), U15.5 (VCC), U16.16 (VCC), U17.20 (VCC), U18.20 (VCC), U19.20 (VCC), U20.20 (VCC), Y1.1 (EN), Y1.8 (Vcc)
/A0: U1.46 (A0), U2.10 (A0), U3.12 (A0), U18.2 (A0)
/A1: U1.47 (A1), U2.9 (A1), U3.11 (A1), U5.2 (RS1), U10.1 (A0), U18.3 (A1)
/A2: U1.48 (A2), U2.8 (A2), U3.10 (A2), U5.3 (RS2), U10.2 (A1), U18.4 (A2)
/A3: U1.1 (A3), U2.7 (A3), U3.9 (A3), U5.4 (RS3), U10.3 (A2), U18.5 (A3)
/A4: U1.2 (A4), U2.6 (A4), U3.8 (A4), U5.5 (RS4), U18.6 (A4)
/A5: U1.3 (A5), U2.5 (A5), U3.7 (A5), U5.6 (RS5), U18.7 (A5)
/A6: U1.4 (A6), U2.4 (A6), U3.6 (A6), U18.8 (A6)
/A7: U1.5 (A7), U2.3 (A7), U3.5 (A7), U18.9 (A7)
/A8: U1.6 (A8), U2.25 (A8), U3.27 (A8), U19.2 (A0)
/A9: U1.7 (A9), U2.24 (A9), U3.26 (A9), U19.3 (A1)
/A10: U1.8 (A10), U2.21 (A10), U3.23 (A10), U19.4 (A2)
/A11: U1.9 (A11), U2.23 (A11), U3.25 (A11), U19.5 (A3)
/A12: U1.10 (A12), U2.2 (A12), U3.4 (A12), U19.6 (A4)
/A13: U1.11 (A13), U2.26 (A13), U3.28 (A13), U19.7 (A5)
/A14: U1.12 (A14), U2.27 (A14), U3.3 (A14), U19.8 (A6)
/A15: U1.14 (A15), U2.1 (A15), U3.31 (A15), U19.9 (A7)
/A16: U1.16 (A16), U3.2 (A16), U9.1 (A0)
/A17: U1.17 (A17), U3.30 (A17), U9.2 (A1)
/A18: U1.18 (A18), U3.1 (A18), U9.3 (A2), U11.12
/A19: U1.19 (A19), U9.6 (E3), U11.1
/CLK: U1.34 (CLK), U6.10 (CLK), U20.8 (A6), Y1.5 (OUT)
/D0: U1.27 (D0), U2.11 (D0), U3.13 (DQ0), U5.37 (D0), U17.2 (A0)
/D1: U1.26 (D1), U2.12 (D1), U3.14 (DQ1), U5.38 (D1), U17.3 (A1)
/D2: U1.25 (D2), U2.13 (D2), U3.15 (DQ2), U5.39 (D2), U17.4 (A2)
/D3: U1.24 (D3), U2.15 (D3), U3.17 (DQ3), U5.40 (D3), U17.5 (A3)
/D4: U1.23 (D4), U2.16 (D4), U3.18 (DQ4), U5.41 (D4), U17.6 (A4)
/D5: U1.22 (D5), U2.17 (D5), U3.19 (DQ5), U5.42 (D5), U17.7 (A5)
/D6: U1.21 (D6), U2.18 (D6), U3.20 (DQ6), U5.43 (D6), U17.8 (A6)
/D7: U1.20 (D7), U2.19 (D7), U3.21 (DQ7), U5.44 (D7), U17.9 (A7)
/E: U1.38 (E), U20.9 (A7)
/FC0: U1.45 (FC0), U8.1 (A0)
/FC1: U1.44 (FC1), U8.2 (A1)
/FC2: U1.43 (FC2), U8.3 (A2)
/IOI0: J2.13, J4.13, R9.1
/IOI1: J2.14, J4.14, R10.1
/IOI2: J2.15, J4.15, R11.1
/IOI3: J2.16, J4.16, R12.1
/IOI4: J2.17, J4.17, R13.1
/IOI5: J2.18, J4.18, R14.1
/IOI6: J2.19, J4.19, R15.1
/IOI7: J2.20, J4.20, R16.1
/MFP_CK: U5.17 (X1), U5.35 (CLK), U6.7 (Q1)
/R/~W: U1.30 (R/~W), U3.29 (WE#), U5.1 (R/W), U12.5, U20.4 (A2)
/W/~R: U2.22 (~OE), U3.24 (OE#), U12.6, U17.1 (A->B)
/XA0: J1.22, J3.22, U18.18 (Y0)
/XA1: J1.23, J3.23, U18.17 (Y1)
/XA2: J1.24, J3.24, U18.16 (Y2)
/XA3: J1.25, J3.25, U18.15 (Y3)
/XA4: J1.27, J3.27, U18.14 (Y4)
/XA5: J1.28, J3.28, U18.13 (Y5)
/XA6: J1.29, J3.29, U18.12 (Y6)
/XA7: J1.30, J3.30, U18.11 (Y7)
/XA8: J1.32, J3.32, U19.18 (Y0)
/XA9: J1.33, J3.33, U19.17 (Y1)
/XA10: J1.34, J3.34, U19.16 (Y2)
/XA11: J1.35, J3.35, U19.15 (Y3)
/XA12: J1.37, J3.37, U19.14 (Y4)
/XA13: J1.38, J3.38, U19.13 (Y5)
/XA14: J1.39, J3.39, U19.12 (Y6)
/XA15: J1.40, J3.40, U19.11 (Y7)
/XCLK: J2.10, J4.10, U20.12 (Y6)
/XD0: J1.2, J3.2, U17.18 (B0)
/XD1: J1.3, J3.3, U17.17 (B1)
/XD2: J1.4, J3.4, U17.16 (B2)
/XD3: J1.5, J3.5, U17.15 (B3)
/XD4: J1.7, J3.7, U17.14 (B4)
/XD5: J1.8, J3.8, U17.13 (B5)
/XD6: J1.9, J3.9, U17.12 (B6)
/XD7: J1.10, J3.10, U17.11 (B7)
/XE: J2.28, J4.28, U20.11 (Y7)
/XR/~W: J2.6, J4.6, U20.16 (Y2)
/X~AS: J2.3, J4.3, U20.18 (Y0)
/X~DS: J2.4, J2.5, J4.4, J4.5, U20.17 (Y1)
/uart_Rx: J5.3, U5.9 (SI), U16.12 (R1OUT)
/uart_Tx: J5.2, U5.8 (SO), U16.11 (T1IN)
/uart_clk: U5.7 (TC), U5.10 (RC), U6.2 (Q5)
/~AS: U1.28 (~AS), U8.5 (E2), U9.5 (E2), U18.1 (G1), U19.1 (G1), U20.2 (A0)
/~DS: U1.29 (~DS), U5.47 (DS), U11.2, U11.9, U11.13, U20.3 (A1)
/~DTACK: J2.12, J4.12, R1.2, U1.31 (~DTACK), U4.2, U4.8, U4.10
/~EX0: J2.23, U9.11 (O4)
/~EX1: J4.23, U9.10 (O5)
/~HALT: R6.2, U1.36 (~HALT), U4.6
/~INT5: J2.26, J4.26, R18.2, U7.2 (I5)
/~INT7: J2.27, J4.27, R19.2, U7.4 (I7)
/~INTACK2: U5.45 (IACK), U10.13 (O2)
/~INTACK5: J2.24, J4.24, U10.10 (O5)
/~INTACK7: J2.25, J4.25, U10.7 (O7)
/~IPL0/2: U1.42 (~IPL2/~IPL0), U7.9 (S0)
/~IPL1: U1.41 (~IPL1), U7.7 (S1)
/~MFP_INT: R17.2, U5.32 (IRQ), U7.12 (I2)
/~MFP: U5.48 (CS), U9.14 (O1)
/~RAM_acces: U3.22 (CE#), U4.9, U11.6
/~RAM_active: U11.5, U14.5 (Q)
/~RESET: J2.11, J4.11, R7.2, U1.37 (~RESET), U4.4, U5.21 (RESET), U14.4 (~S)
/~ROM_acces: U2.20 (~CE), U4.1, U11.8
/~ROM_addr: U9.15 (O0), U12.3, U13.9
/~VPA: J2.29, J4.29, R4.2, U1.39 (~VPA)
/~intack: U8.7 (O7), U10.5 (E2)
GND: C1.2, C2.2, C3.2, C4.2, C5.2, C6.2, C7.2, C8.2, C9.2, C10.2, C11.2, C12.2, C13.2, C14.2, C15.2, C16.2, C17.2, C18.2, C19.2, C20.2, C21.2, C22.2, C23.2, C26.2, C27.2, J1.1, J1.6, J1.11, J1.16, J1.21, J1.26, J1.31, J1.36, J2.1, J2.2, J2.21, J2.22, J3.1, J3.6, J3.11, J3.16, J3.21, J3.26, J3.31, J3.36, J4.1, J4.2, J4.21, J4.22, J5.6, J6.2, J7.2, J8.0 (PAD), J8.5, SW1.2, U1.15 (GND), U1.35 (GND), U2.14 (GND), U3.16 (VSS), U4.7 (GND), U4.13, U5.34 (IEI), U5.36 (GND), U6.8 (VSS), U6.11 (Reset), U7.5 (EI), U7.8 (GND), U7.10 (IO), U8.4 (E1), U8.8 (GND), U9.4 (E1), U9.8 (GND), U10.4 (E1), U10.8 (GND), U11.7 (GND), U12.1, U12.7 (GND), U12.13, U13.1, U13.2, U13.4, U13.5, U13.7 (GND), U13.12, U13.13, U14.2 (D), U14.7 (GND), U14.11 (C), U14.12 (D), U14.13 (~R), U15.3 (GND), U16.8 (R2IN), U16.10 (T2IN), U16.15 (GND), U17.10 (GND), U18.10 (GND), U18.19 (G2), U19.10 (GND), U19.19 (G2), U20.1 (G1), U20.5 (A3), U20.6 (A4), U20.7 (A5), U20.10 (GND), U20.19 (G2), Y1.4 (GND)
unnamed: C1.1, D1.2 (A), R20.2, SW1.1, U15.2
unnamed: R5.2, U1.40 (~BERR)
unnamed: R3.2, U1.32 (~BG)
unnamed: R2.2, U1.33 (~BR)
unnamed: R8.2, U4.11, U5.46 (DTACK)
unnamed: R9.2, U5.22 (I0)
unnamed: R10.2, U5.23 (I1)
unnamed: R11.2, U5.24 (I2)
unnamed: R12.2, U5.25 (I3)
unnamed: R13.2, U5.26 (I4)
unnamed: R14.2, U5.27 (I5)
unnamed: R15.2, U5.28 (I6)
unnamed: R16.2, U5.29 (I7)
unnamed: U11.3, U11.4
unnamed: U11.10, U13.8
unnamed: U4.3, U12.8
unnamed: U4.5, U12.10
unnamed: U12.9, U12.11, U15.4
unnamed: U12.4, U14.3 (C)
unnamed: U13.10, U14.6 (~Q)
unnamed: C24.1, U16.1 (C1+)
unnamed: C24.2, U16.3 (C1-)
unnamed: C25.1, U16.4 (C2+)
unnamed: C25.2, U16.5 (C2-)
unnamed: J8.3, U16.13 (R1IN)
unnamed: J8.2, U16.14 (T1OUT)
unnamed: C27.1, U16.2 (VS+)
unnamed: C26.1, U16.6 (VS-)
unnamed: U11.11, U17.19 (CE)

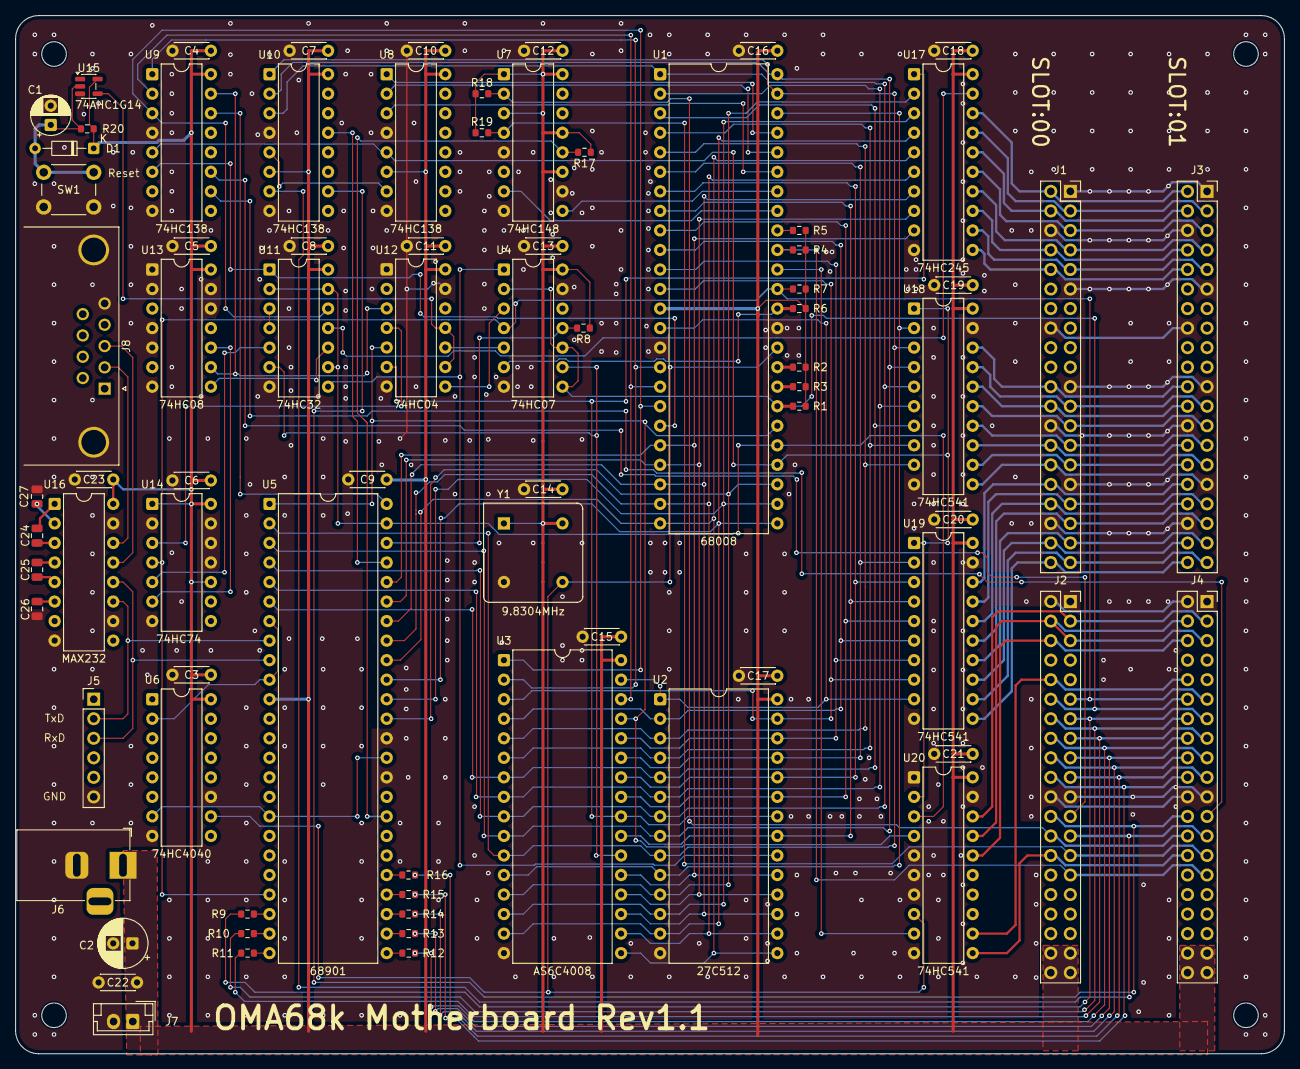
[picture p14: board circuit/68k8-boad-fix/68k8-boad.kicad_pcb from above]

Board: 2 copper layers, 165.0 x 135.0 mm, 82 parts (0 on the bottom side), 129 nets.
