Lintaroh/OMA68k/circuit/SD-board-pico/SD-board-pico.kicad_pcb

## KiCad design circuit/SD-board-pico/SD-board-pico.kicad_pcb (2026-05-15)

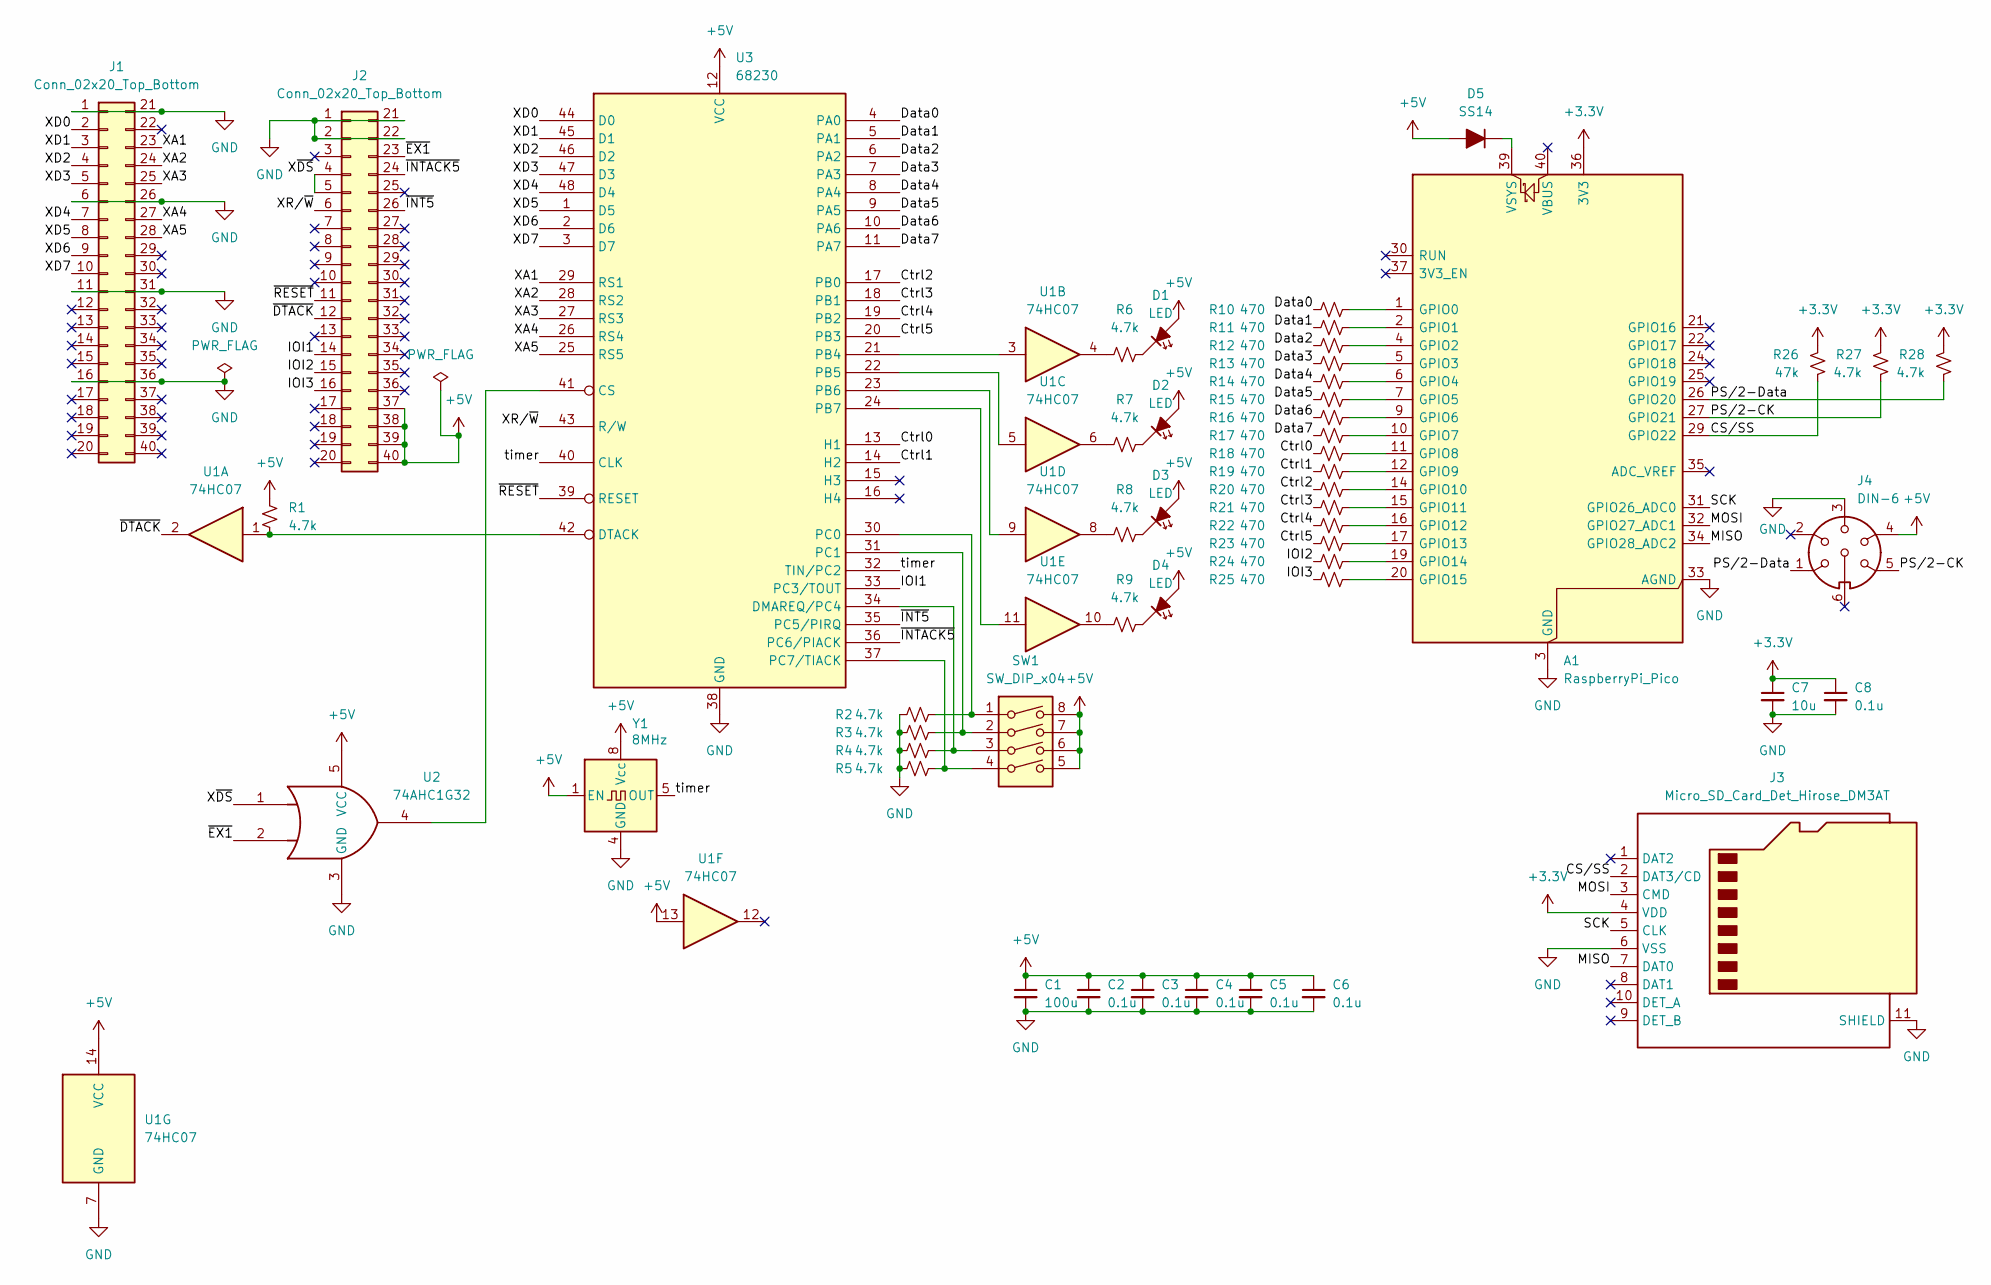
[picture p15: schematic SD-board-pico.kicad_sch]

Parts:
A1: RaspberryPi_Pico; RaspberryPi_Pico_Common_Unspecified
C1: 100u; CP_Radial_D6.3mm_P2.50mm
C2, C3, C4, C5, C6, C8: 0.1u; C_Disc_D4.3mm_W1.9mm_P5.00mm
C7: 10u; CP_Radial_D5.0mm_P2.50mm
D1, D2, D3, D4: LED; LED_0603_1608Metric
D5: SS14; D_SMA
J1, J2: Conn_02x20_Top_Bottom; PinHeader_2x20_P2.54mm_Vertical
J3: Micro_SD_Card_Det_Hirose_DM3AT; microSD_HC_Hirose_DM3AT-SF-PEJM5
J4: DIN-6; MiniDIN6-PS_2
R1, R2, R3, R4, R5, R6, R7, R8, R9, R27, R28: 4.7k; R_0603_1608Metric
R10, R11, R12, R13, R14, R15, R16, R17, R18, R19, R20, R21, R22, R23, R24, R25: 470; R_0603_1608Metric
R26: 47k; R_0603_1608Metric
SW1: SW_DIP_x04; SOIC-8_5.3x6.2mm_P1.27mm
U1: 74HC07; DIP-14_W7.62mm
U2: 74AHC1G32; SOT-23-5_HandSoldering
U3: 68230; DIP-48_W15.24mm
Y1: 8MHz; Oscillator_DIP-8

Connections:
+3.3V: A1.36 (3V3), C7.1, C8.1, J3.4 (VDD), R26.1, R27.1, R28.1
+5V: C1.1, C2.1, C3.1, C4.1, C5.1, C6.1, D1.2 (A), D2.2 (A), D3.2 (A), D4.2 (A), D5.2 (A), J2.37, J2.38, J2.39, J2.40, J4.4, R1.1, SW1.5, SW1.6, SW1.7, SW1.8, U1.13, U1.14 (VCC), U2.5 (VCC), U3.12 (VCC), Y1.1 (EN), Y1.8 (Vcc)
/CS/SS: A1.29 (GPIO22), J3.2 (DAT3/CD), R26.2
/Ctrl0: R18.1, U3.13 (H1)
/Ctrl1: R19.1, U3.14 (H2)
/Ctrl2: R20.1, U3.17 (PB0)
/Ctrl3: R21.1, U3.18 (PB1)
/Ctrl4: R22.1, U3.19 (PB2)
/Ctrl5: R23.1, U3.20 (PB3)
/Data0: R10.1, U3.4 (PA0)
/Data1: R11.1, U3.5 (PA1)
/Data2: R12.1, U3.6 (PA2)
/Data3: R13.1, U3.7 (PA3)
/Data4: R14.1, U3.8 (PA4)
/Data5: R15.1, U3.9 (PA5)
/Data6: R16.1, U3.10 (PA6)
/Data7: R17.1, U3.11 (PA7)
/IOI1: J2.14, U3.33 (PC3/TOUT)
/IOI2: J2.15, R24.1
/IOI3: J2.16, R25.1
/MISO: A1.34 (GPIO28_ADC2), J3.7 (DAT0)
/MOSI: A1.32 (GPIO27_ADC1), J3.3 (CMD)
/PS/2-CK: A1.27 (GPIO21), J4.5, R27.2
/PS/2-Data: A1.26 (GPIO20), J4.1, R28.2
/SCK: A1.31 (GPIO26_ADC0), J3.5 (CLK)
/XA1: J1.23, U3.29 (RS1)
/XA2: J1.24, U3.28 (RS2)
/XA3: J1.25, U3.27 (RS3)
/XA4: J1.27, U3.26 (RS4)
/XA5: J1.28, U3.25 (RS5)
/XD0: J1.2, U3.44 (D0)
/XD1: J1.3, U3.45 (D1)
/XD2: J1.4, U3.46 (D2)
/XD3: J1.5, U3.47 (D3)
/XD4: J1.7, U3.48 (D4)
/XD5: J1.8, U3.1 (D5)
/XD6: J1.9, U3.2 (D6)
/XD7: J1.10, U3.3 (D7)
/XR/~W: J2.6, U3.43 (R/W)
/X~DS: J2.4, J2.5, U2.1
/timer: U3.32 (TIN/PC2), U3.40 (CLK), Y1.5 (OUT)
/~DTACK: J2.12, U1.2
/~EX1: J2.23, U2.2
/~INT5: J2.26, U3.35 (PC5/PIRQ)
/~INTACK5: J2.24, U3.36 (PC6/PIACK)
/~RESET: J2.11, U3.39 (RESET)
GND: A1.3 (GND), A1.8 (GND), A1.13 (GND), A1.18 (GND), A1.23 (GND), A1.28 (GND), A1.33 (AGND), A1.38 (GND), C1.2, C2.2, C3.2, C4.2, C5.2, C6.2, C7.2, C8.2, J1.1, J1.6, J1.11, J1.16, J1.21, J1.26, J1.31, J1.36, J2.1, J2.2, J2.21, J2.22, J3.6 (VSS), J3.11 (SHIELD), J4.3, R2.1, R3.1, R4.1, R5.1, U1.7 (GND), U2.3 (GND), U3.38 (GND), Y1.4 (GND)
unnamed: A1.1 (GPIO0), R10.2
unnamed: A1.2 (GPIO1), R11.2
unnamed: A1.4 (GPIO2), R12.2
unnamed: A1.5 (GPIO3), R13.2
unnamed: A1.6 (GPIO4), R14.2
unnamed: A1.7 (GPIO5), R15.2
unnamed: A1.9 (GPIO6), R16.2
unnamed: A1.10 (GPIO7), R17.2
unnamed: A1.11 (GPIO8), R18.2
unnamed: A1.12 (GPIO9), R19.2
unnamed: A1.14 (GPIO10), R20.2
unnamed: A1.15 (GPIO11), R21.2
unnamed: A1.16 (GPIO12), R22.2
unnamed: A1.17 (GPIO13), R23.2
unnamed: A1.19 (GPIO14), R24.2
unnamed: A1.20 (GPIO15), R25.2
unnamed: A1.39 (VSYS), D5.1 (K)
unnamed: D1.1 (K), R6.2
unnamed: D2.1 (K), R7.2
unnamed: D3.1 (K), R8.2
unnamed: D4.1 (K), R9.2
unnamed: R6.1, U1.4
unnamed: R7.1, U1.6
unnamed: R8.1, U1.8
unnamed: R9.1, U1.10
unnamed: U2.4, U3.41 (CS)
unnamed: R4.2, SW1.3, U3.34 (DMAREQ/PC4)
unnamed: R1.2, U1.1, U3.42 (DTACK)
unnamed: U1.3, U3.21 (PB4)
unnamed: U1.5, U3.22 (PB5)
unnamed: U1.9, U3.23 (PB6)
unnamed: U1.11, U3.24 (PB7)
unnamed: R2.2, SW1.1, U3.30 (PC0)
unnamed: R3.2, SW1.2, U3.31 (PC1)
unnamed: R5.2, SW1.4, U3.37 (PC7/TIACK)

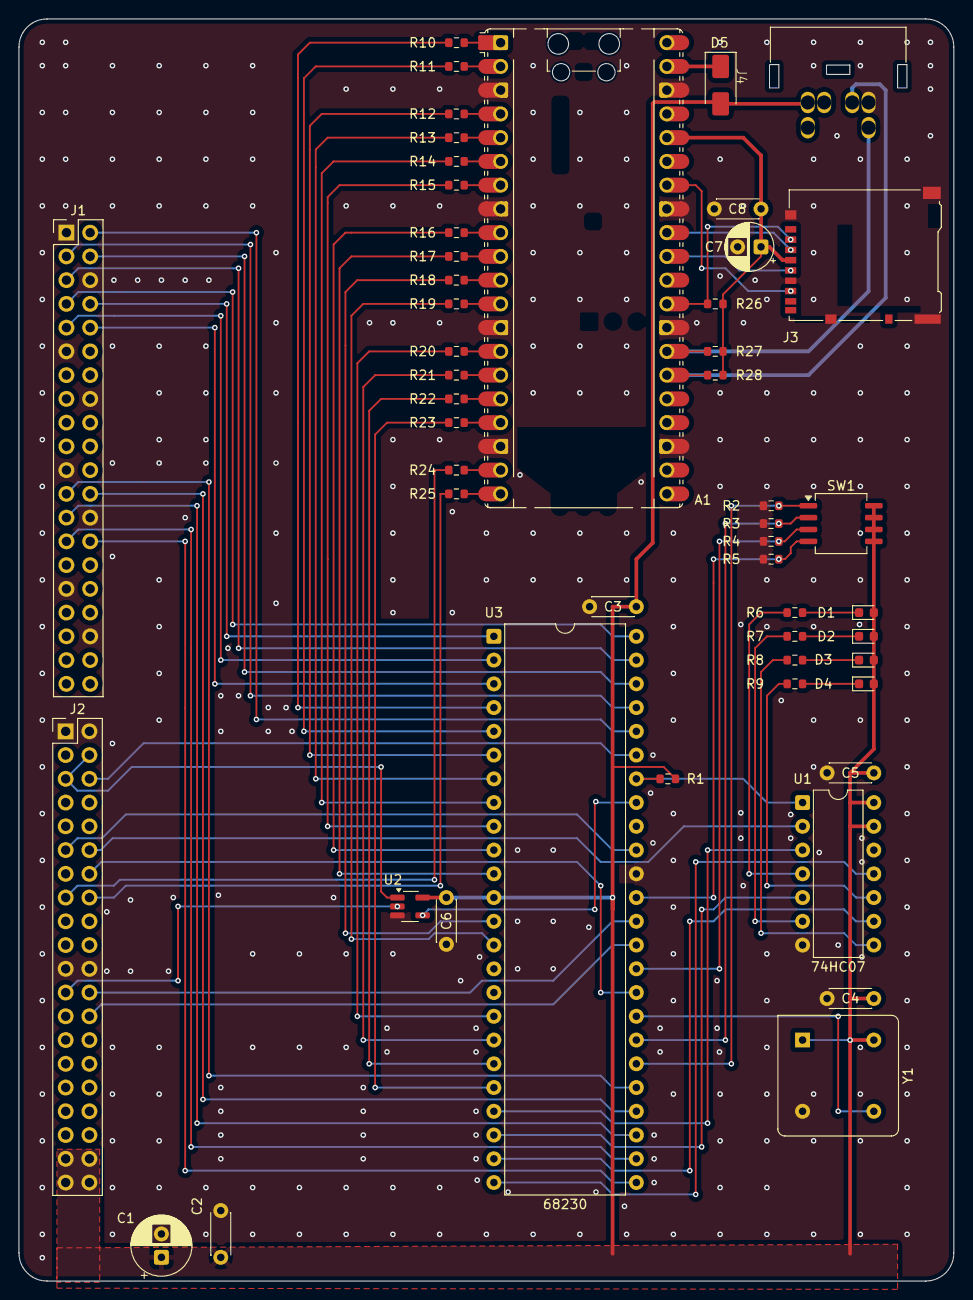
[picture p16: board SD-board-pico.kicad_pcb from above]

Board: 2 copper layers, 100.0 x 135.0 mm, 51 parts (0 on the bottom side), 82 nets.
